brandonbraun653/Ichnaea/hw/ver3/ChargerDesign.md

- Some thoughts on power limitations and low voltage spec.
-
