brandonbraun653/Ichnaea/hw/ver3/InverterDesign.md

- Shall have two power inputs
  - One for a low voltage input (12-100VDC) that goes to an (optional) on-board boost converter.
  - Another for high voltage input (250-480VDC) that can directly feed the inverter.
- Networked control via RS485
