brandonbraun653/Ichnaea/hw/design/ltc7871_ltc7060_dc2886a_buck.asc

C1: cap; 47p
C2: cap; .1µ
C3: cap; 47p
C4: cap; .1µ
C5: cap; 4.7µ
C6: cap; 100p
C7: cap; 1µ
C8: cap; 4.7µ
C9: cap; 1µ
C10: cap; 1µ
C11: cap; .22µ
C12: cap; .22µ
C13: cap; 6.4µ; Rser=31m
C14: polcap; 1300µ; m=6; Rser=20m
C15: cap; 1.1µ; x2; Rser=6m
C16: polcap; 33µ; m=12; Rser=36m
C17: cap; .1µ
C18: cap; .47µ
C19: cap; 1µ
C20: cap; .22µ
C21: cap; .22µ
C22: cap; 6.4µ; Rser=31m
C23: cap; 1.1µ; x2; Rser=6m
C24: cap; .47µ
C25: cap; .1µ
C26: cap; 1µ
C27: cap; .22µ
C28: cap; .22µ
C29: cap; 6.4µ; Rser=31m
C30: cap; 1.1µ; x2; Rser=6m
C31: cap; .1µ
C32: cap; .47µ
C33: cap; 1µ
C34: cap; .22µ
C35: cap; .22µ
C36: cap; 6.4µ; Rser=31m
C37: cap; 1.1µ; x2; Rser=6m
C38: cap; .47µ
C39: cap; .1µ
C40: cap; 1µ
C41: cap; .22µ
C42: cap; .22µ
C43: cap; 6.4µ; Rser=31m
C44: cap; 1.1µ; x2; Rser=6m
C45: cap; .1µ
C46: cap; .47µ
C47: cap; 1µ
C48: cap; .22µ
C49: cap; .22µ
C50: cap; 6.4µ; Rser=31m
C51: cap; 1.1µ; x2; Rser=6m
C52: cap; .47µ
C53: cap; .1µ
C54: cap; 470p
C55: cap; 47p
D1: schottky; RB168MM100
D2: schottky; RB168MM100
D3: schottky; RB168MM100
D4: schottky; RB168MM100
D5: schottky; RB168MM100
D6: schottky; RB168MM100
D7: schottky; RSX205L-30
L1: ind; 4.7µ; Rser=1.6m
L2: ind; 4.7µ; Rser=1.6m
L3: ind; 4.7µ; Rser=1.6m
L4: ind; 4.7µ; Rser=1.6m
L5: ind; 4.7µ; Rser=1.6m
L6: ind; 4.7µ; Rser=1.6m
M1: NMOS; BSC123N08NS3; m=2
M2: NMOS; BSC047N08NS3; m=2
M3: NMOS; BSC123N08NS3; m=2
M4: NMOS; BSC047N08NS3; m=2
M5: NMOS; BSC123N08NS3; m=2
M6: NMOS; BSC047N08NS3; m=2
M7: NMOS; BSC123N08NS3; m=2
M8: NMOS; BSC047N08NS3; m=2
M9: NMOS; BSC123N08NS3; m=2
M10: NMOS; BSC047N08NS3; m=2
M11: NMOS; BSC123N08NS3; m=2
M12: NMOS; BSC047N08NS3; m=2
R1: res; 107K
R2: res; 10K
R3: res; 1K
R4: res; 3.01K
R5: res; 499K
R6: res; 12.7K
R7: res; 45.3K
R8: res; 3.01Meg
R9: res; 48.7K
R10: res; 210K
R11: res; 10K
R12: res; 130K
R13: res; 10K
R14: res; 10K
R15: res; 51K
R17: res; 2.2
R18: res; 10K
R19: res; 30.1K
R20: res; 37.4K
R21: res; 10
R22: res; 0
R24: res; 6.2k
R25: res; 6.2k
R28: res; 10
R29: res; 0
R31: res; 6.2k
R32: res; 6.2k
R34: res; 10
R35: res; 0
R37: res; 6.2k
R38: res; 6.2k
R40: res; 10
R41: res; 0
R43: res; 6.2k
R44: res; 6.2k
R46: res; 10
R47: res; 0
R49: res; 6.2k
R50: res; 6.2k
R52: res; 10
R53: res; 0
R55: res; 6.2k
R56: res; 6.2k
Rload: res; 100
U1: LTC7871
U2: LTC7060
U3: LTC7060
U4: LTC7060
U5: LTC7060
U6: LTC7060
U7: LTC7060
V1: voltage; 48
Named nets: 0, V5, PWMEN, DRVcc, HIGH, LOW, DRVCC
.tran 1.5m startup
Cnom
10u
Cnom
10u
Cnom
10u
Cnom
10u
Cnom
10u
Cnom
10u
Cnom
2.2u
Cnom
2.2u
Cnom
2.2u
Cnom
2.2u
Cnom
2.2u
Cnom
2.2u
LTC7871 High Power PolyPhase Bi-Directional Supply / Charger
48V-to-14V, 6-Phase, 2.5kW Bidirectional Supply/Charger - Buck Mode
HIGH (Input): 30V - 60V  LOW (Output): 14V @ 180A
Note:
  Functions related to SCLK, SDI, SDO and CSB are not modeled
  If the simulation model is not found please update with the "Sync Release" command from the "Tools" menu.
  It remains the customer's responsibility to verify proper and reliable operation in the actual application.
  Component substitution and printed circuit board layout may significantly affect circuit performance or reliability.
  Contact your local sales representative for assistance. This circuit is distributed to customers only for use with ADI parts.
  Copyright © 2021 Analog Devices Inc. All rights reserved.
