brandonbraun653/Ichnaea/hw/ver3/ChargerV3/ChargerV3.kicad_pcb

## KiCad design hw/ver3/ChargerV3/ChargerV3.kicad_pcb (2025-03-12)

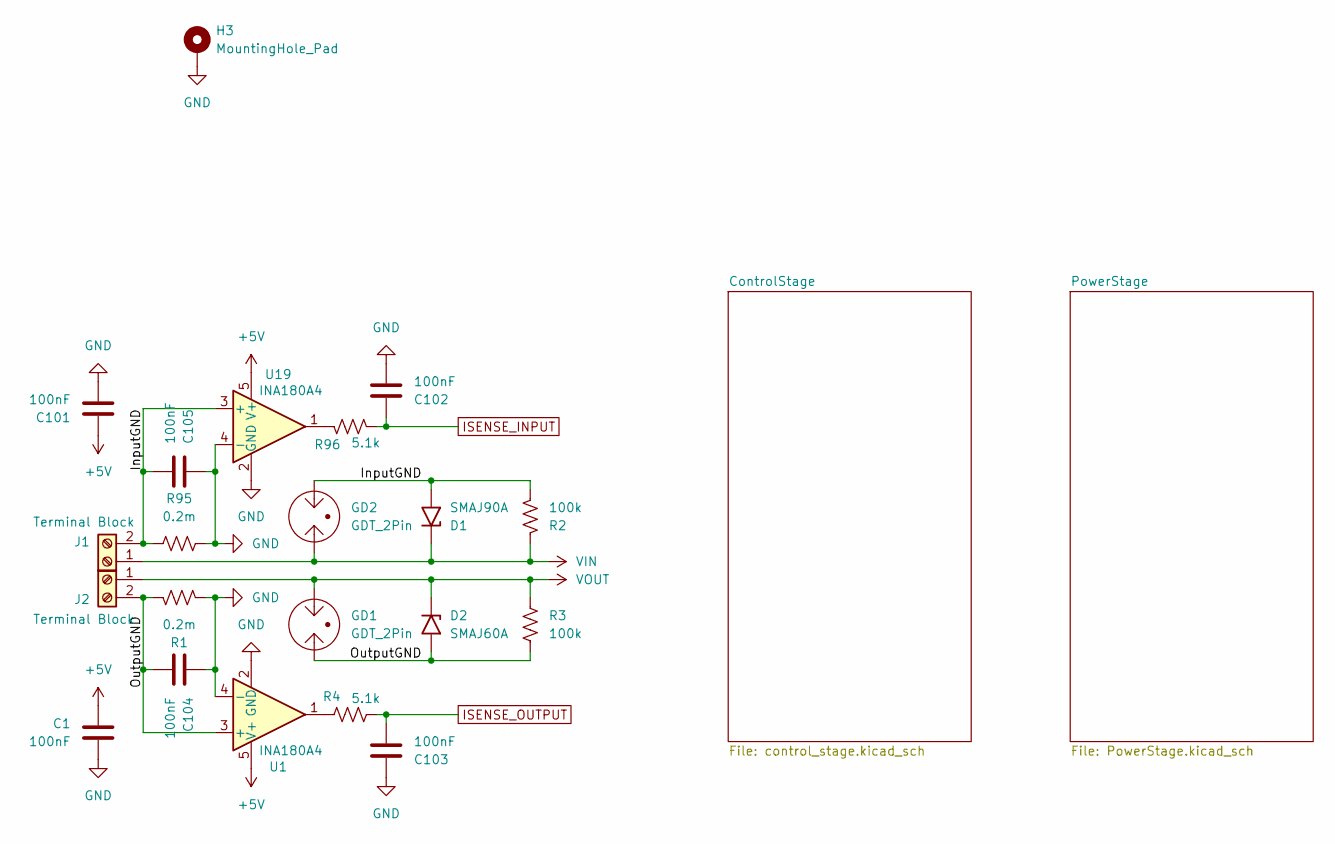
[picture p1: schematic ChargerV3.kicad_sch]

Parts:
C1, C101, C102, C103, C104, C105: 100nF; C_0603_1608Metric; LCSC C14663
D1: SMAJ90A; D_SMA; LCSC C2989723
D2: SMAJ60A; D_SMA; LCSC C707480
GD1, GD2: GDT_2Pin; Fuse_1812_4532Metric_Pad1.30x3.40mm_HandSolder; LCSC C78323
H3: MountingHole_Pad; MountingHole_3.2mm_M3_Pad_Via; Digikey N/A
J1, J2: Terminal Block; KF88SA-16.0-2P; LCSC C707749
R1, R95: 0.2m; Shunt_5930; LCSC C22446543
R2, R3: 100k; R_1206_3216Metric; LCSC C17900
R4, R96: 5.1k; R_0603_1608Metric; LCSC C23186
U1, U19: INA180A4; SOT-23-5; LCSC C188337

Connections:
+5V: C1.1, C101.1, U1.5 (V+), U19.5 (V+); also elsewhere on the board
/InputGND: C105.2, D1.2 (A2), GD2.2, J1.2, R2.2, R95.1, U19.3 (+)
/OutputGND: C104.2, D2.2 (A2), GD1.1, J2.2, R1.1, R3.2, U1.3 (+)
GND: C1.2, C101.2, C102.2, C103.1, C104.1, C105.1, H3.1, R1.2, R95.2, U1.2 (GND), U1.4 (-), U19.2 (GND), U19.4 (-); also elsewhere on the board
ISENSE_INPUT: C102.1, R96.1; also elsewhere on the board
ISENSE_OUTPUT: C103.2, R4.1; also elsewhere on the board
unnamed: R4.2, U1.1
unnamed: R96.2, U19.1
VIN: D1.1 (A1), GD2.1, J1.1, R2.1; also elsewhere on the board
VOUT: D2.1 (A1), GD1.2, J2.1, R3.1; also elsewhere on the board

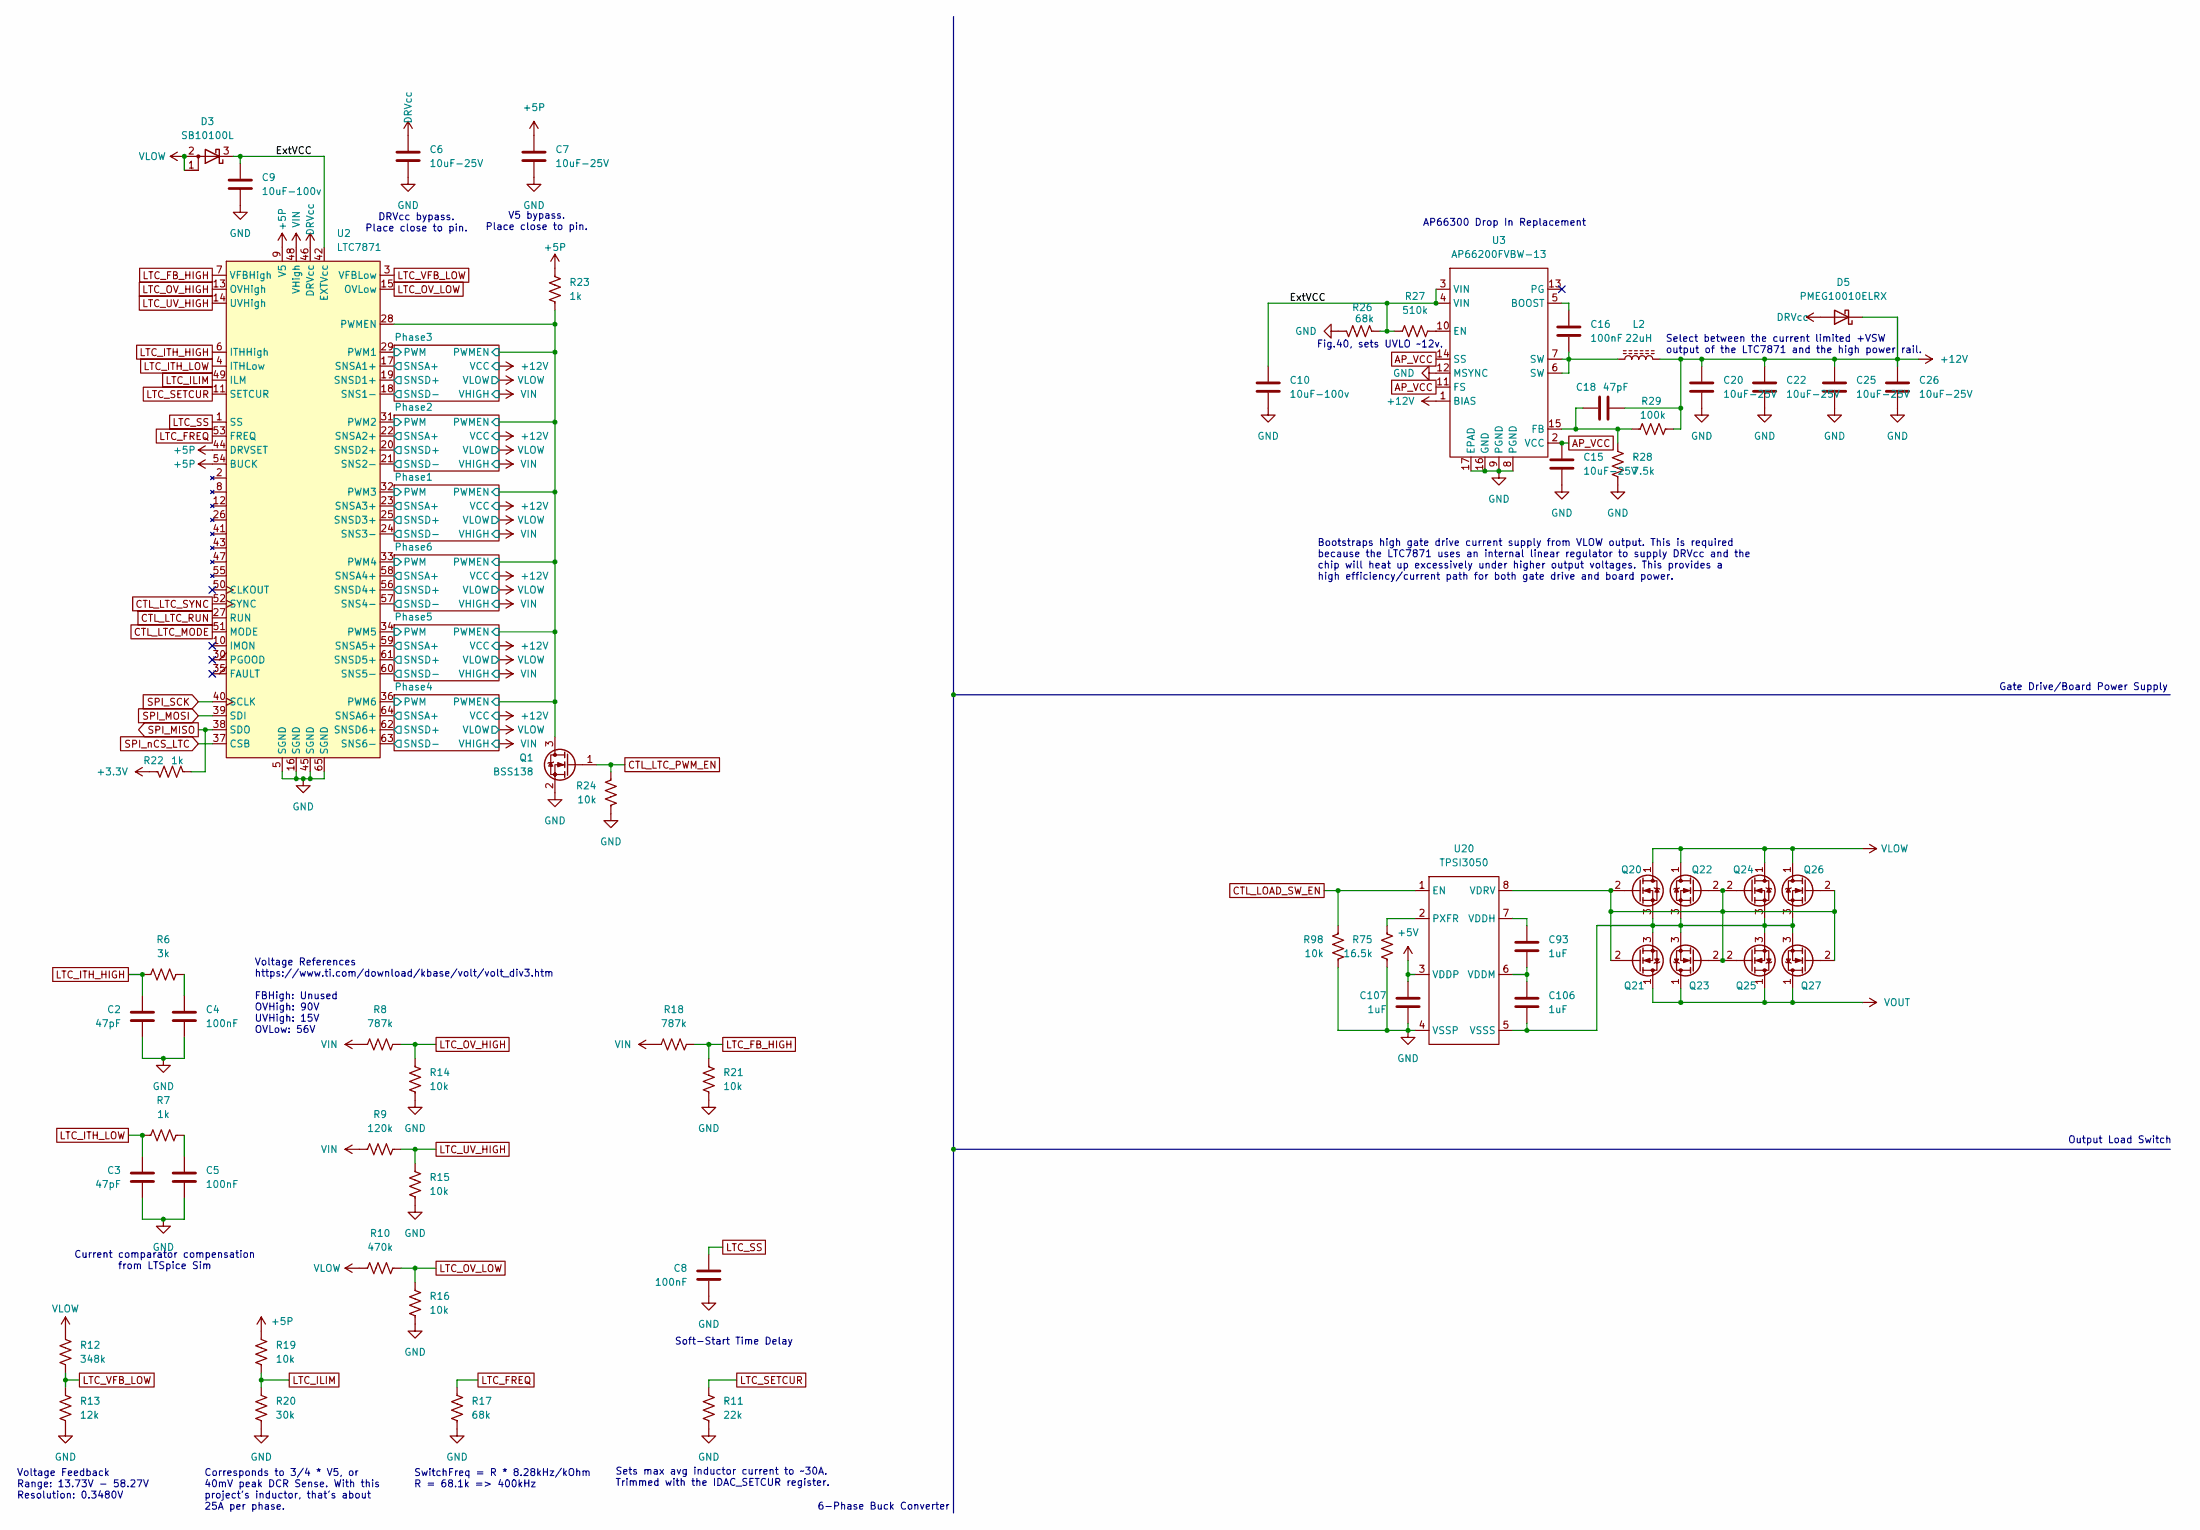
[picture p2: schematic PowerStage.kicad_sch]

Parts:
C2, C3, C18: 47pF; C_0603_1608Metric; LCSC C1671
C4, C5, C8, C16: 100nF; C_0603_1608Metric; LCSC C14663
C6: 10uF-25V; C_0603_1608Metric; Voltage 25; Digikey N/A
C7, C15, C20, C22, C25, C26: 10uF-25V; C_0603_1608Metric; Digikey N/A
C9, C10: 10uF-100v; C_1210_3225Metric_Pad1.33x2.70mm_HandSolder; Digikey 445-CGA6P1X7R1N106M250ACCT-ND
C93, C106, C107: 1uF; C_0603_1608Metric; LCSC C15849
D3: SB10100L; TO-277A; LCSC C113946
D5: PMEG10010ELRX; D_SOD-123; LCSC C179426
L2: 22uH; L_Wuerth_HCI-1040; Digikey N/A
Q1: BSS138; SOT-23; Digikey 5272-BSS138CT-ND
Q20, Q21, Q22, Q23, Q24, Q25, Q26, Q27: HYG053N10NS1C2; TRANS_BSC076N06NS3-G; Digikey N/A
R6: 3k; R_0603_1608Metric; Digikey N/A
R7, R22: 1k; R_0603_1608Metric; Digikey N/A
R8, R18: 787k; R_0805_2012Metric; Digikey P787KHCT-ND
R9: 120k; R_0805_2012Metric; Digikey N/A
R10: 470k; R_0805_2012Metric; LCSC C17709
R11: 22k; R_0603_1608Metric; LCSC C31850
R12: 348k; R_0603_1608Metric; LCSC C23006
R13: 12k; R_0603_1608Metric; LCSC C22790
R14, R15, R16, R19, R21, R24, R98: 10k; R_0603_1608Metric; LCSC C25804
R17: 68k; R_0603_1608Metric; Digikey N/A
R20: 30k; R_0603_1608Metric; Digikey N/A
R23: 1k; R_0603_1608Metric; LCSC C21190
R26: 68k; R_0603_1608Metric; LCSC C23231
R27: 510k; R_0603_1608Metric; LCSC C23192
R28: 7.5k; R_0603_1608Metric; LCSC C23234
R29: 100k; R_0603_1608Metric; LCSC C25803
R75: 16.5k; R_0603_1608Metric; LCSC C2933155
U2: LTC7871; LQFP-64-1EP_10x10mm_P0.5mm_EP6.5x6.5mm; Digikey 505-LTC7871ELWE#PBF-ND
U3: AP66200FVBW-13; QFN-16-1EP_4x4mm_P0.65mm_EP2.5x2.5mm; Digikey 31-AP66200FVBW-13CT-ND
U20: TPSI3050; SOIC-8_7.5x5.85mm_P1.27mm

Connections:
+3.3V: R22.2; also elsewhere on the board
+5P: C7.1, R19.2, R23.2, U2.9 (V5), U2.44 (DRVSET), U2.54 (BUCK)
+5V: C107.1, U20.3 (VDDP); also elsewhere on the board
+12V: C18.2, C20.1, C22.1, C25.1, C26.1, D5.1 (K), L2.2, R29.2, U3.1 (BIAS); also elsewhere on the board
/PowerStage/ExtVCC: C9.1, C10.1, D3.3 (K), R26.1, R27.1, U2.42 (EXTVcc), U3.3 (VIN), U3.4 (VIN)
/PowerStage/Phase1/PWM: U2.32 (PWM3); also elsewhere on the board
/PowerStage/Phase1/PWMEN: Q1.3 (D), R23.1, U2.28 (PWMEN); also elsewhere on the board
/PowerStage/Phase1/SNSA+: U2.23 (SNSA3+); also elsewhere on the board
/PowerStage/Phase1/SNSD+: U2.25 (SNSD3+); also elsewhere on the board
/PowerStage/Phase2/PWM: U2.31 (PWM2); also elsewhere on the board
/PowerStage/Phase2/SNSA+: U2.22 (SNSA2+); also elsewhere on the board
/PowerStage/Phase2/SNSD+: U2.20 (SNSD2+); also elsewhere on the board
/PowerStage/Phase3/PWM: U2.29 (PWM1); also elsewhere on the board
/PowerStage/Phase3/SNSA+: U2.17 (SNSA1+); also elsewhere on the board
/PowerStage/Phase3/SNSD+: U2.19 (SNSD1+); also elsewhere on the board
/PowerStage/Phase4/PWM: U2.36 (PWM6); also elsewhere on the board
/PowerStage/Phase4/SNSA+: U2.64 (SNSA6+); also elsewhere on the board
/PowerStage/Phase4/SNSD+: U2.62 (SNSD6+); also elsewhere on the board
/PowerStage/Phase5/PWM: U2.34 (PWM5); also elsewhere on the board
/PowerStage/Phase5/SNSA+: U2.59 (SNSA5+); also elsewhere on the board
/PowerStage/Phase5/SNSD+: U2.61 (SNSD5+); also elsewhere on the board
/PowerStage/Phase6/PWM: U2.33 (PWM4); also elsewhere on the board
/PowerStage/Phase6/SNSA+: U2.58 (SNSA4+); also elsewhere on the board
/PowerStage/Phase6/SNSD+: U2.56 (SNSD4+); also elsewhere on the board
AP_VCC: C15.1, U3.2 (VCC), U3.11 (FS), U3.14 (SS)
CTL_LOAD_SW_EN: R98.2, U20.1 (EN); also elsewhere on the board
CTL_LTC_MODE: U2.51 (MODE); also elsewhere on the board
CTL_LTC_PWM_EN: Q1.1 (G), R24.2; also elsewhere on the board
CTL_LTC_RUN: U2.27 (RUN); also elsewhere on the board
CTL_LTC_SYNC: U2.52 (SYNC); also elsewhere on the board
DRVcc: C6.1, D5.2 (A), U2.46 (DRVcc)
GND: C2.2, C3.2, C4.2, C5.2, C6.2, C7.2, C8.2, C9.2, C10.2, C15.2, C20.2, C22.2, C25.2, C26.2, C107.2, Q1.2 (S), R11.1, R13.1, R14.1, R15.1, R16.1, R17.1, R20.1, R21.1, R24.1, R26.2, R28.2, R75.2, R98.1, U2.5 (SGND), U2.16 (SGND), U2.45 (SGND), U2.65 (SGND), U3.8 (PGND), U3.9 (PGND), U3.12 (MSYNC), U3.16 (GND), U3.17 (EPAD), U20.4 (VSSP); also elsewhere on the board
LTC_FB_HIGH: R18.2, R21.2, U2.7 (VFBHigh)
LTC_FREQ: R17.2, U2.53 (FREQ)
LTC_ILIM: R19.1, R20.2, U2.49 (ILM)
LTC_ITH_HIGH: C2.1, R6.2, U2.6 (ITHHigh)
LTC_ITH_LOW: C3.1, R7.2, U2.4 (ITHLow)
LTC_OV_HIGH: R8.2, R14.2, U2.13 (OVHigh)
LTC_OV_LOW: R10.2, R16.2, U2.15 (OVLow)
LTC_SETCUR: R11.2, U2.11 (SETCUR)
LTC_SS: C8.1, U2.1 (SS)
LTC_UV_HIGH: R9.2, R15.2, U2.14 (UVHigh)
LTC_VFB_LOW: R12.1, R13.2, U2.3 (VFBLow)
unnamed: C4.1, R6.1
unnamed: C5.1, R7.1
unnamed: C16.2, L2.1, U3.6 (SW), U3.7 (SW)
unnamed: Q20.2 (G), Q21.2 (G), Q22.2 (G), Q23.2 (G), Q24.2 (G), Q25.2 (G), Q26.2 (G), Q27.2 (G), U20.8 (VDRV)
unnamed: C106.2, Q20.3 (S), Q21.3 (S), Q22.3 (S), Q23.3 (S), Q24.3 (S), Q25.3 (S), Q26.3 (S), Q27.3 (S), U20.5 (VSSS)
unnamed: C16.1, U3.5 (BOOST)
unnamed: R27.2, U3.10 (EN)
unnamed: C18.1, R28.1, R29.1, U3.15 (FB)
unnamed: R75.1, U20.2 (PXFR)
unnamed: C93.1, U20.7 (VDDH)
unnamed: C93.2, C106.1, U20.6 (VDDM)
SPI_MISO: R22.1, U2.38 (SDO); also elsewhere on the board
SPI_MOSI: U2.39 (SDI); also elsewhere on the board
SPI_SCK: U2.40 (SCLK); also elsewhere on the board
SPI_nCS_LTC: U2.37 (CSB); also elsewhere on the board
VIN: R8.1, R9.1, R18.1, U2.48 (VHigh); also elsewhere on the board
VLOW: D3.1 (A), D3.2 (A), Q20.1 (D), Q22.1 (D), Q24.1 (D), Q26.1 (D), R10.1, R12.2, U2.18 (SNS1-), U2.21 (SNS2-), U2.24 (SNS3-), U2.57 (SNS4-), U2.60 (SNS5-), U2.63 (SNS6-); also elsewhere on the board
VOUT: Q21.1 (D), Q23.1 (D), Q25.1 (D), Q27.1 (D); also elsewhere on the board

Notes on the sheet:
SwitchFreq = R * 8.28kHz/kOhm R = 68.1k => 400kHz
Output Load Switch
Fig.40, sets UVLO ~12v.
V5 bypass. Place close to pin.
Bootstraps high gate drive current supply from VLOW output. This is required because the LTC7871 uses an internal linear regulator to supply DRVcc and the chip will heat up excessively under higher output voltages. This provides a high efficiency/current path for both gate drive and board power.
Sets max avg inductor current to ~30A. Trimmed with the IDAC_SETCUR register.
Corresponds to 3/4 * V5, or 40mV peak DCR Sense. With this project's inductor, that's about 25A per phase.
6-Phase Buck Converter
Select between the current limited +VSW output of the LTC7871 and the high power rail.
Voltage Feedback Range: 13.73V - 58.27V Resolution: 0.3480V
Current comparator compensation from LTSpice Sim
Soft-Start Time Delay
AP66300 Drop In Replacement
Voltage References https://www.ti.com/download/kbase/volt/volt_div3.htm FBHigh: Unused OVHigh: 90V UVHigh: 15V OVLow: 56V
DRVcc bypass. Place close to pin.
Gate Drive/Board Power Supply

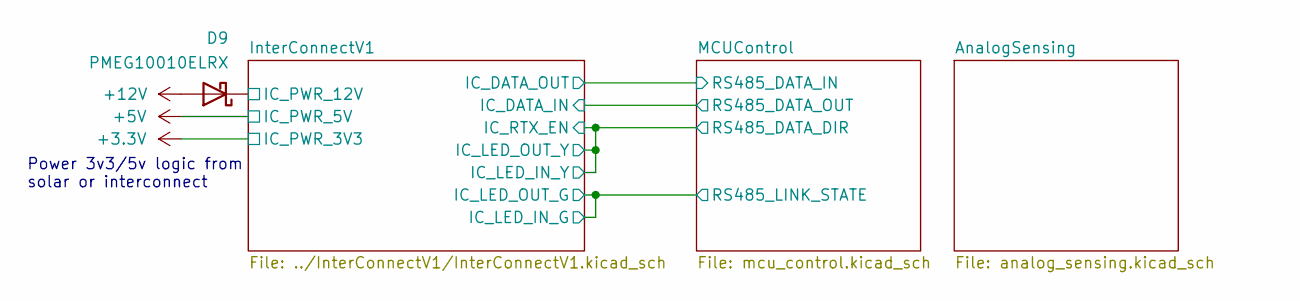
[picture p3: schematic control_stage.kicad_sch]

Parts:
D9: PMEG10010ELRX; D_SOD-123; LCSC C179426

Connections:
+12V: D9.2 (A); also elsewhere on the board
/ControlStage/InterConnectV1/IC_PWR_12V: D9.1 (K); also elsewhere on the board

Notes on the sheet:
Power 3v3/5v logic from solar or interconnect

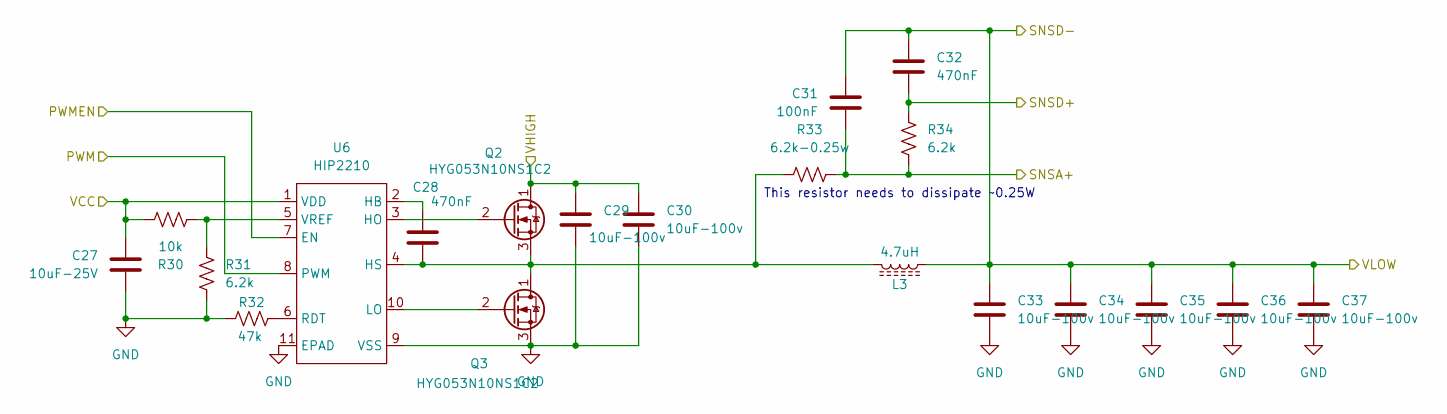
[picture p4: schematic PhaseNDriver.kicad_sch]

Parts:
C27: 10uF-25V; C_0603_1608Metric; Digikey N/A
C28, C32: 470nF; C_0603_1608Metric; Digikey N/A
C29, C30, C33, C34, C35, C36, C37: 10uF-100v; C_1210_3225Metric_Pad1.33x2.70mm_HandSolder; Digikey 445-CGA6P1X7R1N106M250ACCT-ND
C31: 100nF; C_0603_1608Metric; LCSC C14663
L3: 4.7uH; Bournes_L_PQ2614BLA; Digikey PQ2614BLA-3R3K-ND
Q2, Q3: HYG053N10NS1C2; TRANS_BSC076N06NS3-G; Digikey N/A
R30: 10k; R_0603_1608Metric; LCSC C25804
R31, R34: 6.2k; R_0603_1608Metric; Digikey N/A
R32: 47k; R_0603_1608Metric; Digikey N/A
R33: 6.2k-0.25w; R_1206_3216Metric_Pad1.30x1.75mm_HandSolder; Digikey 311-6.20KFRCT-ND
U6: HIP2210; TDFN-10-1EP_4x4mm_P0.8mm_EP2.6x3mm; Digikey 20-HIP2210FRTZ-TCT-ND

Connections:
+12V: C27.1, R30.1, U6.1 (VDD); also elsewhere on the board
/PowerStage/Phase1/PWM: U6.8 (PWM); also elsewhere on the board
/PowerStage/Phase1/PWMEN: U6.7 (EN); also elsewhere on the board
/PowerStage/Phase1/SNSA+: C31.2, R33.2, R34.2; also elsewhere on the board
/PowerStage/Phase1/SNSD+: C32.2, R34.1; also elsewhere on the board
GND: C27.2, C29.2, C30.2, C33.2, C34.2, C35.2, C36.2, C37.2, Q3.3 (S), R31.2, R32.1, U6.9 (VSS), U6.11 (EPAD); also elsewhere on the board
unnamed: Q2.2 (G), U6.3 (HO)
unnamed: C28.2, L3.2, Q2.3 (S), Q3.1 (D), R33.1, U6.4 (HS)
unnamed: Q3.2 (G), U6.10 (LO)
unnamed: C28.1, U6.2 (HB)
unnamed: R32.2, U6.6 (RDT)
unnamed: R30.2, R31.1, U6.5 (VREF)
VIN: C29.1, C30.1, Q2.1 (D); also elsewhere on the board
VLOW: C31.1, C32.1, C33.1, C34.1, C35.1, C36.1, C37.1, L3.1; also elsewhere on the board

Parts of its further copies:
C38, C49, C60, C71, C82: 10uF-25V; C_0603_1608Metric; Digikey N/A
C39, C43, C50, C54, C61, C65, C72, C76, C83, C87: 470nF; C_0603_1608Metric; Digikey N/A
C40, C41, C44, C45, C46, C47, C48, C51, C52, C55, C56, C57, C58, C59, C62, C63, C66, C67, C68, C69, C70, C73, C74, C77, C78, C79, C80, C81, C84, C85, C88, C89, C90, C91, C92: 10uF-100v; C_1210_3225Metric_Pad1.33x2.70mm_HandSolder; Digikey 445-CGA6P1X7R1N106M250ACCT-ND
C42, C53, C64, C75, C86: 100nF; C_0603_1608Metric; LCSC C14663
L4, L5, L6, L7, L8: 4.7uH; Bournes_L_PQ2614BLA; Digikey PQ2614BLA-3R3K-ND
Q4, Q5, Q6, Q7, Q8, Q9, Q10, Q11, Q17, Q18: HYG053N10NS1C2; TRANS_BSC076N06NS3-G; Digikey N/A
R35, R40, R45, R50, R69: 10k; R_0603_1608Metric; LCSC C25804
R36, R39, R41, R44, R46, R49, R51, R54, R70, R73: 6.2k; R_0603_1608Metric; Digikey N/A
R37, R42, R47, R52, R71: 47k; R_0603_1608Metric; Digikey N/A
R38, R43, R48, R53, R72: 6.2k-0.25w; R_1206_3216Metric_Pad1.30x1.75mm_HandSolder; Digikey 311-6.20KFRCT-ND
U7, U8, U9, U10, U11: HIP2210; TDFN-10-1EP_4x4mm_P0.8mm_EP2.6x3mm; Digikey 20-HIP2210FRTZ-TCT-ND

Connections of its further copies:
+12V: C38.1, C49.1, C60.1, C71.1, C82.1, R35.1, R40.1, R45.1, R50.1, R69.1, U7.1 (VDD), U8.1 (VDD), U9.1 (VDD), U10.1 (VDD), U11.1 (VDD); also elsewhere on the board
/PowerStage/Phase1/PWMEN: U7.7 (EN), U8.7 (EN), U9.7 (EN), U10.7 (EN), U11.7 (EN); also elsewhere on the board
/PowerStage/Phase2/PWM: U7.8 (PWM); also elsewhere on the board
/PowerStage/Phase2/SNSA+: C42.2, R38.2, R39.2; also elsewhere on the board
/PowerStage/Phase2/SNSD+: C43.2, R39.1; also elsewhere on the board
/PowerStage/Phase3/PWM: U8.8 (PWM); also elsewhere on the board
/PowerStage/Phase3/SNSA+: C53.2, R43.2, R44.2; also elsewhere on the board
/PowerStage/Phase3/SNSD+: C54.2, R44.1; also elsewhere on the board
/PowerStage/Phase4/PWM: U9.8 (PWM); also elsewhere on the board
/PowerStage/Phase4/SNSA+: C64.2, R48.2, R49.2; also elsewhere on the board
/PowerStage/Phase4/SNSD+: C65.2, R49.1; also elsewhere on the board
/PowerStage/Phase5/PWM: U10.8 (PWM); also elsewhere on the board
/PowerStage/Phase5/SNSA+: C75.2, R53.2, R54.2; also elsewhere on the board
/PowerStage/Phase5/SNSD+: C76.2, R54.1; also elsewhere on the board
/PowerStage/Phase6/PWM: U11.8 (PWM); also elsewhere on the board
/PowerStage/Phase6/SNSA+: C86.2, R72.2, R73.2; also elsewhere on the board
/PowerStage/Phase6/SNSD+: C87.2, R73.1; also elsewhere on the board
GND: C38.2, C40.2, C41.2, C44.2, C45.2, C46.2, C47.2, C48.2, C49.2, C51.2, C52.2, C55.2, C56.2, C57.2, C58.2, C59.2, C60.2, C62.2, C63.2, C66.2, C67.2, C68.2, C69.2, C70.2, C71.2, C73.2, C74.2, C77.2, C78.2, C79.2, C80.2, C81.2, C82.2, C84.2, C85.2, C88.2, C89.2, C90.2, C91.2, C92.2, Q5.3 (S), Q7.3 (S), Q9.3 (S), Q11.3 (S), Q18.3 (S), R36.2, R37.1, R41.2, R42.1, R46.2, R47.1, R51.2, R52.1, R70.2, R71.1, U7.9 (VSS), U7.11 (EPAD), U8.9 (VSS), U8.11 (EPAD), U9.9 (VSS), U9.11 (EPAD), U10.9 (VSS), U10.11 (EPAD), U11.9 (VSS), U11.11 (EPAD); also elsewhere on the board
unnamed: Q4.2 (G), U7.3 (HO)
unnamed: C39.2, L4.2, Q4.3 (S), Q5.1 (D), R38.1, U7.4 (HS)
unnamed: Q5.2 (G), U7.10 (LO)
unnamed: Q6.2 (G), U8.3 (HO)
unnamed: C50.2, L5.2, Q6.3 (S), Q7.1 (D), R43.1, U8.4 (HS)
unnamed: Q7.2 (G), U8.10 (LO)
unnamed: Q8.2 (G), U9.3 (HO)
unnamed: C61.2, L6.2, Q8.3 (S), Q9.1 (D), R48.1, U9.4 (HS)
unnamed: Q9.2 (G), U9.10 (LO)
unnamed: Q10.2 (G), U10.3 (HO)
unnamed: C72.2, L7.2, Q10.3 (S), Q11.1 (D), R53.1, U10.4 (HS)
unnamed: Q11.2 (G), U10.10 (LO)
unnamed: Q17.2 (G), U11.3 (HO)
unnamed: C83.2, L8.2, Q17.3 (S), Q18.1 (D), R72.1, U11.4 (HS)
unnamed: Q18.2 (G), U11.10 (LO)
unnamed: C39.1, U7.2 (HB)
unnamed: R37.2, U7.6 (RDT)
unnamed: R35.2, R36.1, U7.5 (VREF)
unnamed: C50.1, U8.2 (HB)
unnamed: R42.2, U8.6 (RDT)
unnamed: R40.2, R41.1, U8.5 (VREF)
unnamed: C61.1, U9.2 (HB)
unnamed: R47.2, U9.6 (RDT)
unnamed: R45.2, R46.1, U9.5 (VREF)
unnamed: C72.1, U10.2 (HB)
unnamed: R52.2, U10.6 (RDT)
unnamed: R50.2, R51.1, U10.5 (VREF)
unnamed: C83.1, U11.2 (HB)
unnamed: R71.2, U11.6 (RDT)
unnamed: R69.2, R70.1, U11.5 (VREF)
VIN: C40.1, C41.1, C51.1, C52.1, C62.1, C63.1, C73.1, C74.1, C84.1, C85.1, Q4.1 (D), Q6.1 (D), Q8.1 (D), Q10.1 (D), Q17.1 (D); also elsewhere on the board
VLOW: C42.1, C43.1, C44.1, C45.1, C46.1, C47.1, C48.1, C53.1, C54.1, C55.1, C56.1, C57.1, C58.1, C59.1, C64.1, C65.1, C66.1, C67.1, C68.1, C69.1, C70.1, C75.1, C76.1, C77.1, C78.1, C79.1, C80.1, C81.1, C86.1, C87.1, C88.1, C89.1, C90.1, C91.1, C92.1, L4.1, L5.1, L6.1, L7.1, L8.1; also elsewhere on the board

Notes on the sheet:
This resistor needs to dissipate ~0.25W

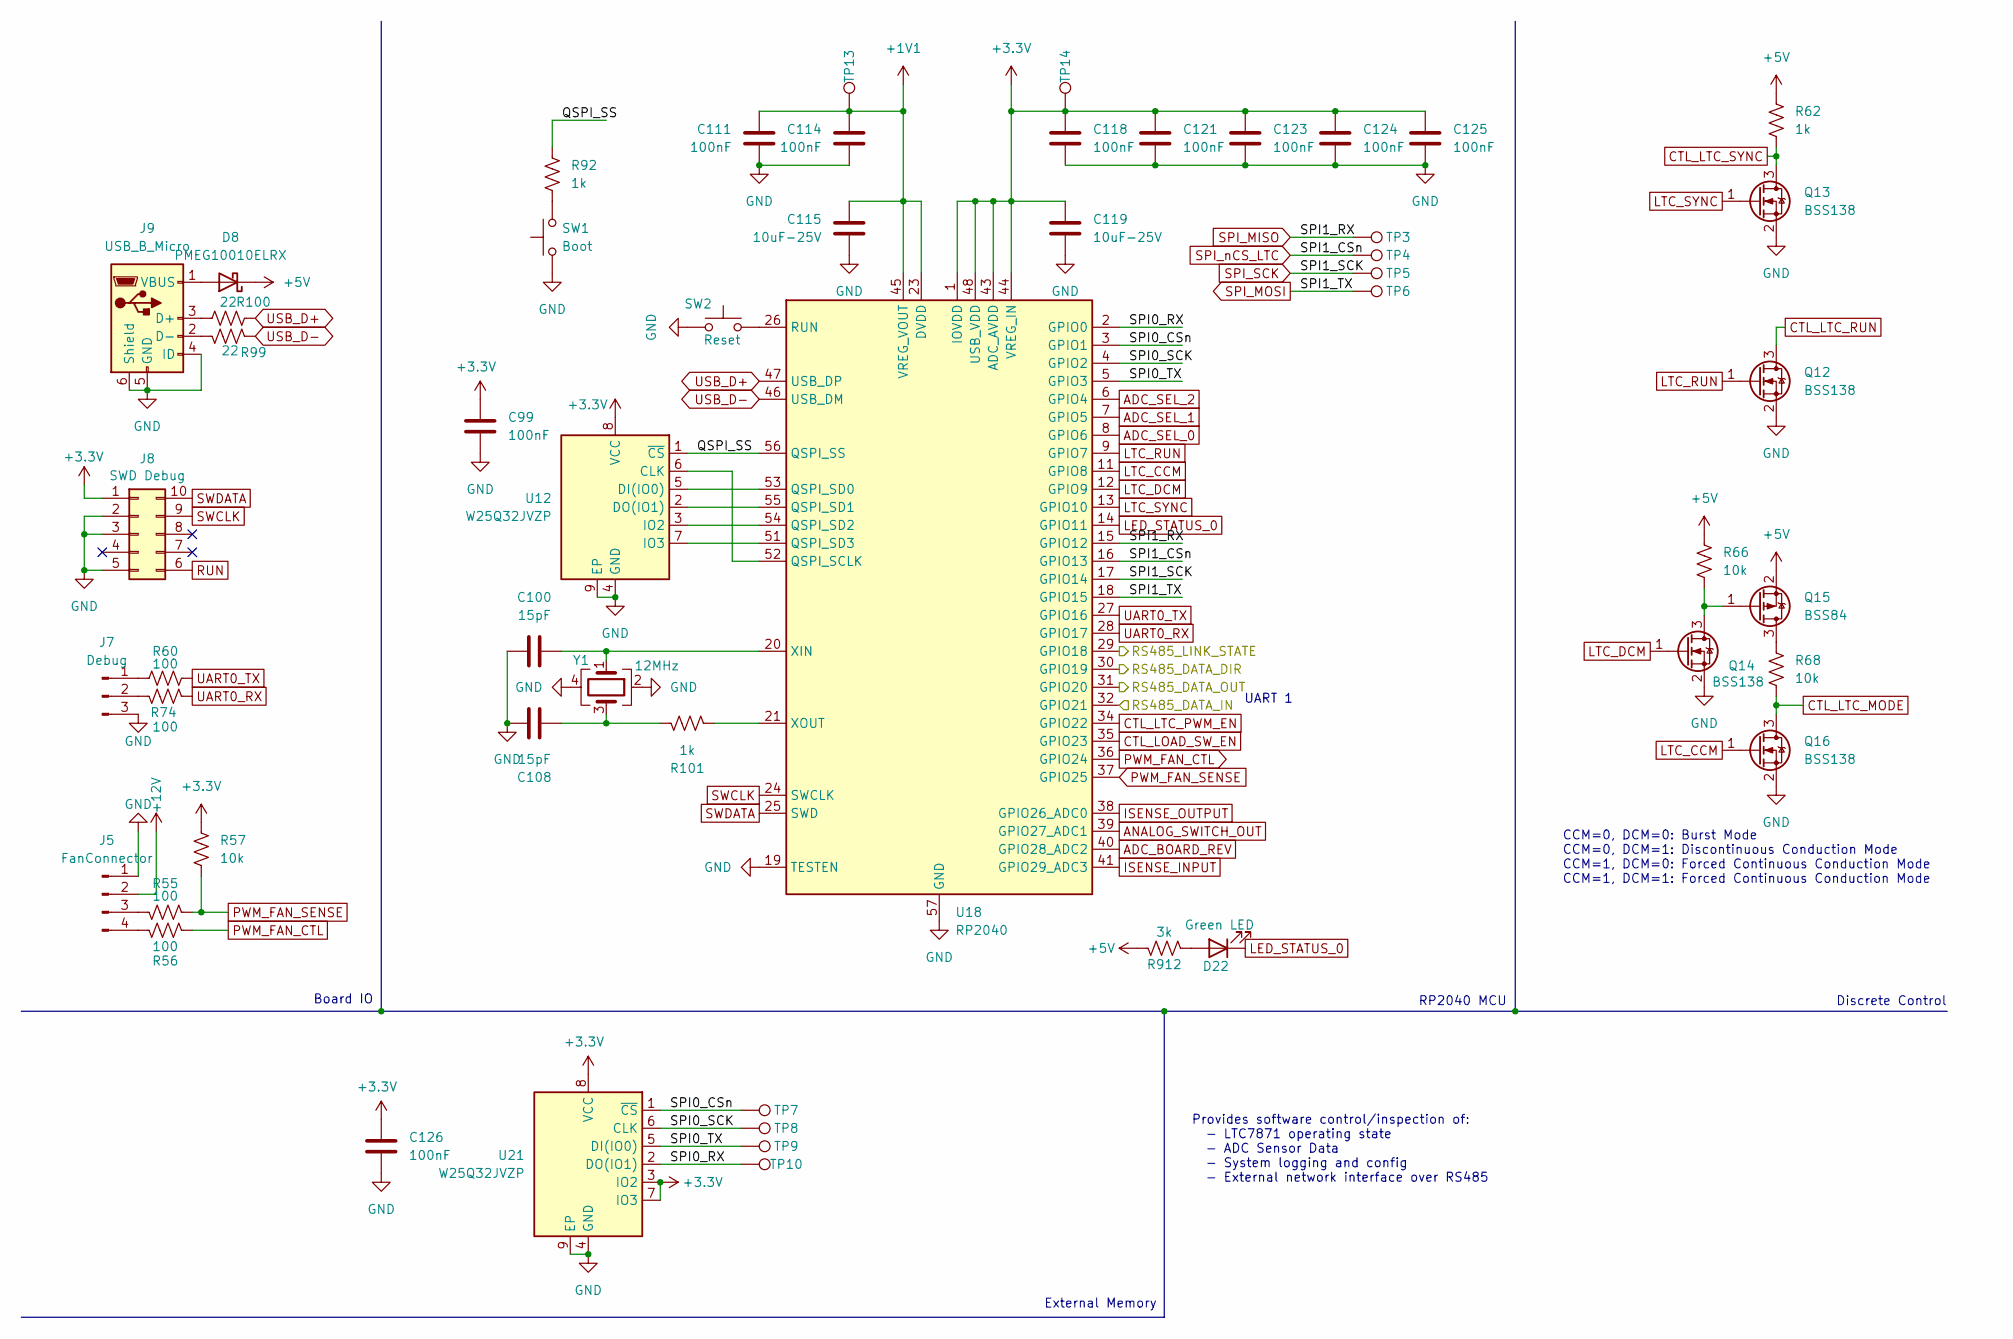
[picture p5: schematic mcu_control.kicad_sch]

Parts:
C99, C111, C114, C118, C121, C123, C124, C125, C126: 100nF; C_0603_1608Metric; LCSC C14663
C100, C108: 15pF; C_0603_1608Metric; Digikey N/A
C115, C119: 10uF-25V; C_0603_1608Metric; Digikey N/A
D8: PMEG10010ELRX; D_SOD-123; LCSC C179426
D22: Green LED; LED_0805_2012Metric; LCSC C2297
J5: FanConnector; Molex_KK-254_AE-6410-04A_1x04_P2.54mm_Vertical; Digikey WM4330-ND
J7: Debug; PinHeader_1x03_P2.54mm_Vertical; Digikey N/A
J8: SWD Debug; JTAG_2x05_P1_27mm_Shrouded_SMD; Digikey 1175-1629-ND
J9: USB_B_Micro; Amphenol-MicroB; LCSC C132350
Q12, Q13, Q14, Q16: BSS138; SOT-23; Digikey 5272-BSS138CT-ND
Q15: BSS84; SOT-23; Digikey 5272-BSS84CT-ND
R55, R56, R60, R74: 100; R_0603_1608Metric; Digikey N/A
R57, R66, R68: 10k; R_0603_1608Metric; LCSC C25804
R62, R92: 1k; R_0603_1608Metric; LCSC C21190
R99, R100: 22; R_0603_1608Metric; LCSC C23345
R101: 1k; R_0603_1608Metric; Digikey N/A
R912: 3k; R_0603_1608Metric; LCSC C126358
SW1: Boot; SW_Tactile_SPST_NO_Straight_CK_PTS636Sx25SMTRLFS; Digikey CKN12321-2-ND
SW2: Reset; SW_Tactile_SPST_NO_Straight_CK_PTS636Sx25SMTRLFS; Digikey CKN12321-2-ND
TP3, TP4, TP5, TP6, TP7, TP8, TP9, TP10, TP13, TP14: TestPoint; TestPoint_Pad_D1.0mm; LCSC N/A
U12, U21: W25Q32JVZP; WSON-8-1EP_6x5mm_P1.27mm_EP3.4x4.3mm; Digikey W25Q32JVZPIQ-ND
U18: RP2040; QFN-56-1EP_7x7mm_P0.4mm_EP3.2x3.2mm; Digikey 2648-SC0914(13)CT-ND
Y1: 12MHz; Crystal_SMD_3225-4Pin_3.2x2.5mm; Digikey XC2613CT-ND

Connections:
+1V1: C111.1, C114.1, C115.1, TP13.1, U18.23 (DVDD), U18.45 (VREG_VOUT), U18.50 (DVDD)
+3.3V: C99.1, C118.1, C119.1, C121.1, C123.1, C124.1, C125.1, C126.1, J8.1, R57.2, TP14.1, U12.8 (VCC), U18.1 (IOVDD), U18.10 (IOVDD), U18.22 (IOVDD), U18.33 (IOVDD), U18.42 (IOVDD), U18.43 (ADC_AVDD), U18.44 (VREG_IN), U18.48 (USB_VDD), U18.49 (IOVDD), U21.3 (IO2), U21.7 (IO3), U21.8 (VCC); also elsewhere on the board
+5V: D8.1 (K), Q15.2 (S), R62.2, R66.2, R912.2; also elsewhere on the board
+12V: J5.2; also elsewhere on the board
/ControlStage/InterConnectV1/IC_DATA_IN: U18.31 (GPIO20); also elsewhere on the board
/ControlStage/InterConnectV1/IC_DATA_OUT: U18.32 (GPIO21); also elsewhere on the board
/ControlStage/InterConnectV1/IC_LED_IN_G: U18.29 (GPIO18); also elsewhere on the board
/ControlStage/InterConnectV1/IC_LED_IN_Y: U18.30 (GPIO19); also elsewhere on the board
/ControlStage/MCUControl/QSPI_SS: R92.2, U12.1 (~CS), U18.56 (QSPI_SS)
/ControlStage/MCUControl/SPI0_CSn: TP7.1, U18.3 (GPIO1), U21.1 (~CS)
/ControlStage/MCUControl/SPI0_RX: TP10.1, U18.2 (GPIO0), U21.2 (DO(IO1))
/ControlStage/MCUControl/SPI0_SCK: TP8.1, U18.4 (GPIO2), U21.6 (CLK)
/ControlStage/MCUControl/SPI0_TX: TP9.1, U18.5 (GPIO3), U21.5 (DI(IO0))
ADC_BOARD_REV: U18.40 (GPIO28_ADC2); also elsewhere on the board
ADC_SEL_0: U18.8 (GPIO6); also elsewhere on the board
ADC_SEL_1: U18.7 (GPIO5); also elsewhere on the board
ADC_SEL_2: U18.6 (GPIO4); also elsewhere on the board
ANALOG_SWITCH_OUT: U18.39 (GPIO27_ADC1); also elsewhere on the board
CTL_LOAD_SW_EN: U18.35 (GPIO23); also elsewhere on the board
CTL_LTC_MODE: Q16.3 (D), R68.2; also elsewhere on the board
CTL_LTC_PWM_EN: U18.34 (GPIO22); also elsewhere on the board
CTL_LTC_RUN: Q12.3 (D); also elsewhere on the board
CTL_LTC_SYNC: Q13.3 (D), R62.1; also elsewhere on the board
GND: C99.2, C100.1, C108.1, C111.2, C114.2, C115.2, C118.2, C119.2, C121.2, C123.2, C124.2, C125.2, C126.2, J5.1, J7.3, J8.2, J8.3, J8.5, J9.4 (ID), J9.5 (GND), J9.6 (Shield), Q12.2 (S), Q13.2 (S), Q14.2 (S), Q16.2 (S), SW1.1, SW2.1, U12.4 (GND), U12.9 (EP), U18.19 (TESTEN), U18.57 (GND), U21.4 (GND), U21.9 (EP), Y1.2, Y1.4; also elsewhere on the board
ISENSE_INPUT: U18.41 (GPIO29_ADC3); also elsewhere on the board
ISENSE_OUTPUT: U18.38 (GPIO26_ADC0); also elsewhere on the board
LED_STATUS_0: D22.1 (K), U18.14 (GPIO11)
LTC_CCM: Q16.1 (G), U18.11 (GPIO8)
LTC_DCM: Q14.1 (G), U18.12 (GPIO9)
LTC_RUN: Q12.1 (G), U18.9 (GPIO7)
LTC_SYNC: Q13.1 (G), U18.13 (GPIO10)
unnamed: C108.2, R101.1, Y1.3
unnamed: D8.2 (A), J9.1 (VBUS)
unnamed: D22.2 (A), R912.1
unnamed: J5.3, R55.2
unnamed: J5.4, R56.1
unnamed: J7.1, R60.1
unnamed: J7.2, R74.1
unnamed: J9.3 (D+), R100.2
unnamed: J9.2 (D-), R99.2
unnamed: Q14.3 (D), Q15.1 (G), R66.1
unnamed: Q15.3 (D), R68.1
unnamed: R92.1, SW1.2
unnamed: U12.6 (CLK), U18.52 (QSPI_SCLK)
unnamed: U12.5 (DI(IO0)), U18.53 (QSPI_SD0)
unnamed: U12.2 (DO(IO1)), U18.55 (QSPI_SD1)
unnamed: U12.3 (IO2), U18.54 (QSPI_SD2)
unnamed: U12.7 (IO3), U18.51 (QSPI_SD3)
unnamed: SW2.2, U18.26 (RUN)
unnamed: C100.2, U18.20 (XIN), Y1.1
unnamed: R101.2, U18.21 (XOUT)
PWM_FAN_CTL: R56.2, U18.36 (GPIO24)
PWM_FAN_SENSE: R55.1, R57.1, U18.37 (GPIO25)
RUN: J8.6
SPI_MISO: TP3.1, U18.15 (GPIO12); also elsewhere on the board
SPI_MOSI: TP6.1, U18.18 (GPIO15); also elsewhere on the board
SPI_SCK: TP5.1, U18.17 (GPIO14); also elsewhere on the board
SPI_nCS_LTC: TP4.1, U18.16 (GPIO13); also elsewhere on the board
SWCLK: J8.9, U18.24 (SWCLK)
SWDATA: J8.10, U18.25 (SWD)
UART0_RX: R74.2, U18.28 (GPIO17)
UART0_TX: R60.2, U18.27 (GPIO16)
USB_D+: R100.1, U18.47 (USB_DP)
USB_D-: R99.1, U18.46 (USB_DM)

Notes on the sheet:
Board IO
UART 1
Provides software control/inspection of: - LTC7871 operating state - ADC Sensor Data - System logging and config - External network interface over RS485
Discrete Control
External Memory
CCM=0, DCM=0: Burst Mode CCM=0, DCM=1: Discontinuous Conduction Mode CCM=1, DCM=0: Forced Continuous Conduction Mode CCM=1, DCM=1: Forced Continuous Conduction Mode
RP2040 MCU

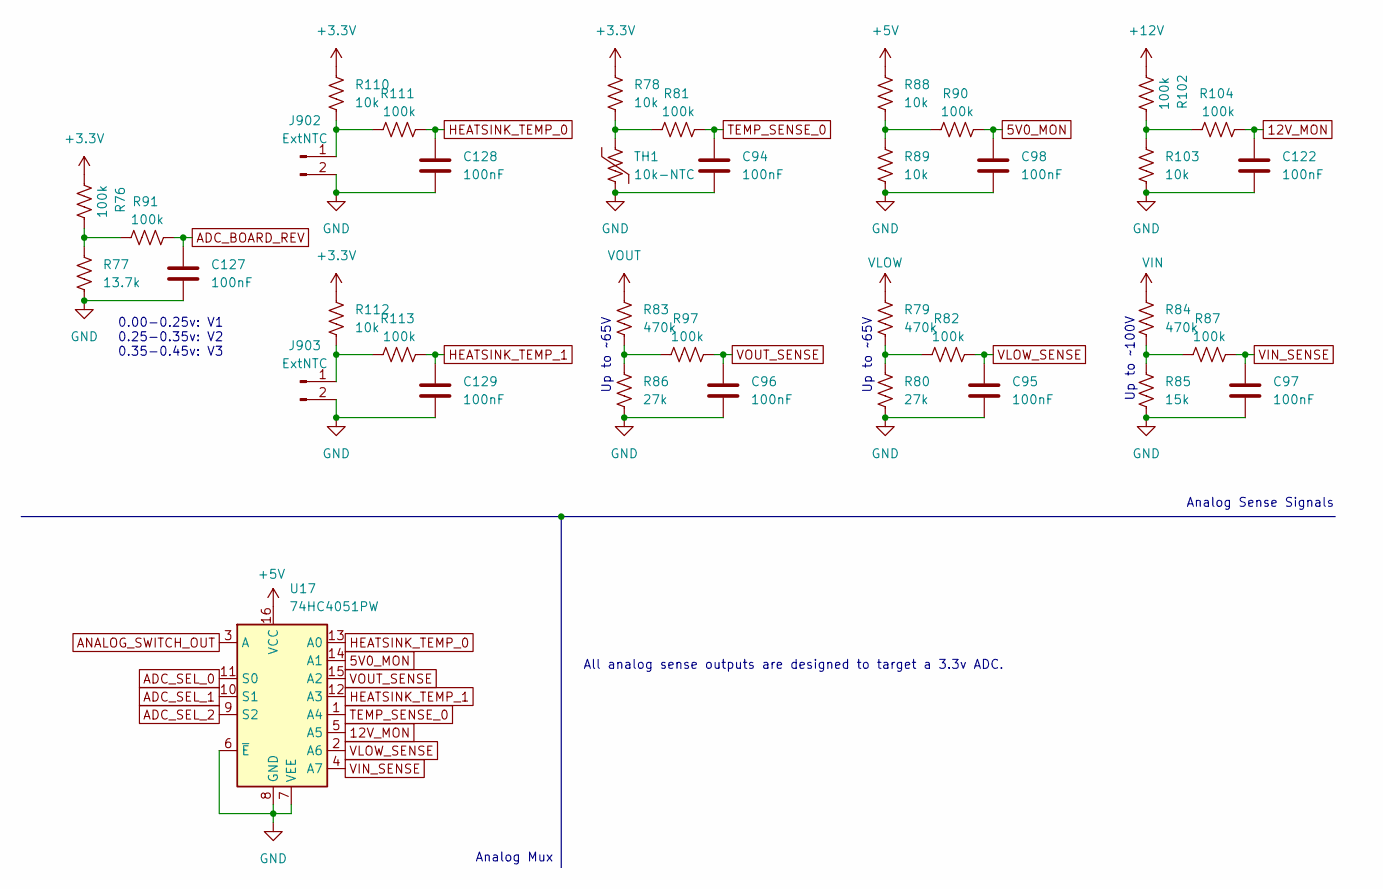
[picture p6: schematic analog_sensing.kicad_sch]

Parts:
C94, C95, C96, C97, C98, C122, C127, C128, C129: 100nF; C_0603_1608Metric; LCSC C14663
J902, J903: ExtNTC; PinHeader_1x02_P2.54mm_Vertical
R76, R81, R82, R87, R90, R91, R97, R102, R104, R111, R113: 100k; R_0603_1608Metric; LCSC C25803
R77: 13.7k; R_0603_1608Metric; LCSC C2930064
R78, R88, R89, R103, R110, R112: 10k; R_0603_1608Metric; LCSC C25804
R79, R83: 470k; R_0805_2012Metric; Digikey N/A
R80, R86: 27k; R_0603_1608Metric; Digikey N/A
R84: 470k; R_0805_2012Metric; LCSC C17709
R85: 15k; R_0603_1608Metric; Digikey N/A
TH1: 10k-NTC; R_0402_1005Metric_Pad0.72x0.64mm_HandSolder; Digikey 445-2550-1-ND
U17: 74HC4051PW; TSSOP-16_4.4x5mm_P0.65mm; Digikey 1727-3064-1-ND

Connections:
5V0_MON: C98.1, R90.2, U17.14 (A1)
12V_MON: C122.1, R104.2, U17.5 (A5)
+3.3V: R76.1, R78.2, R110.2, R112.2; also elsewhere on the board
+5V: R88.2, U17.16 (VCC); also elsewhere on the board
+12V: R102.1; also elsewhere on the board
ADC_BOARD_REV: C127.1, R91.2; also elsewhere on the board
ADC_SEL_0: U17.11 (S0); also elsewhere on the board
ADC_SEL_1: U17.10 (S1); also elsewhere on the board
ADC_SEL_2: U17.9 (S2); also elsewhere on the board
ANALOG_SWITCH_OUT: U17.3 (A); also elsewhere on the board
GND: C94.2, C95.2, C96.2, C97.2, C98.2, C122.2, C127.2, C128.2, C129.2, J902.2, J903.2, R77.1, R80.1, R85.1, R86.1, R89.1, R103.1, TH1.2, U17.6 (~E), U17.7 (VEE), U17.8 (GND); also elsewhere on the board
HEATSINK_TEMP_0: C128.1, R111.2, U17.13 (A0)
HEATSINK_TEMP_1: C129.1, R113.2, U17.12 (A3)
unnamed: J902.1, R110.1, R111.1
unnamed: J903.1, R112.1, R113.1
unnamed: R76.2, R77.2, R91.1
unnamed: R78.1, R81.1, TH1.1
unnamed: R79.1, R80.2, R82.1
unnamed: R83.1, R86.2, R97.1
unnamed: R84.1, R85.2, R87.1
unnamed: R88.1, R89.2, R90.1
unnamed: R102.2, R103.2, R104.1
TEMP_SENSE_0: C94.1, R81.2, U17.1 (A4)
VIN: R84.2; also elsewhere on the board
VIN_SENSE: C97.1, R87.2, U17.4 (A7)
VLOW: R79.2; also elsewhere on the board
VLOW_SENSE: C95.1, R82.2, U17.2 (A6)
VOUT: R83.2; also elsewhere on the board
VOUT_SENSE: C96.1, R97.2, U17.15 (A2)

Notes on the sheet:
Up to ~65V
Analog Sense Signals
0.00-0.25v: V1 0.25-0.35v: V2 0.35-0.45v: V3
Up to ~100V
Analog Mux
All analog sense outputs are designed to target a 3.3v ADC.
