brandonbraun653/Ichnaea/hw/ver3/ChargerV3/ChargerV3.kicad_pcb

## KiCad design hw/ver3/ChargerV3/ChargerV3.kicad_pcb (continued)

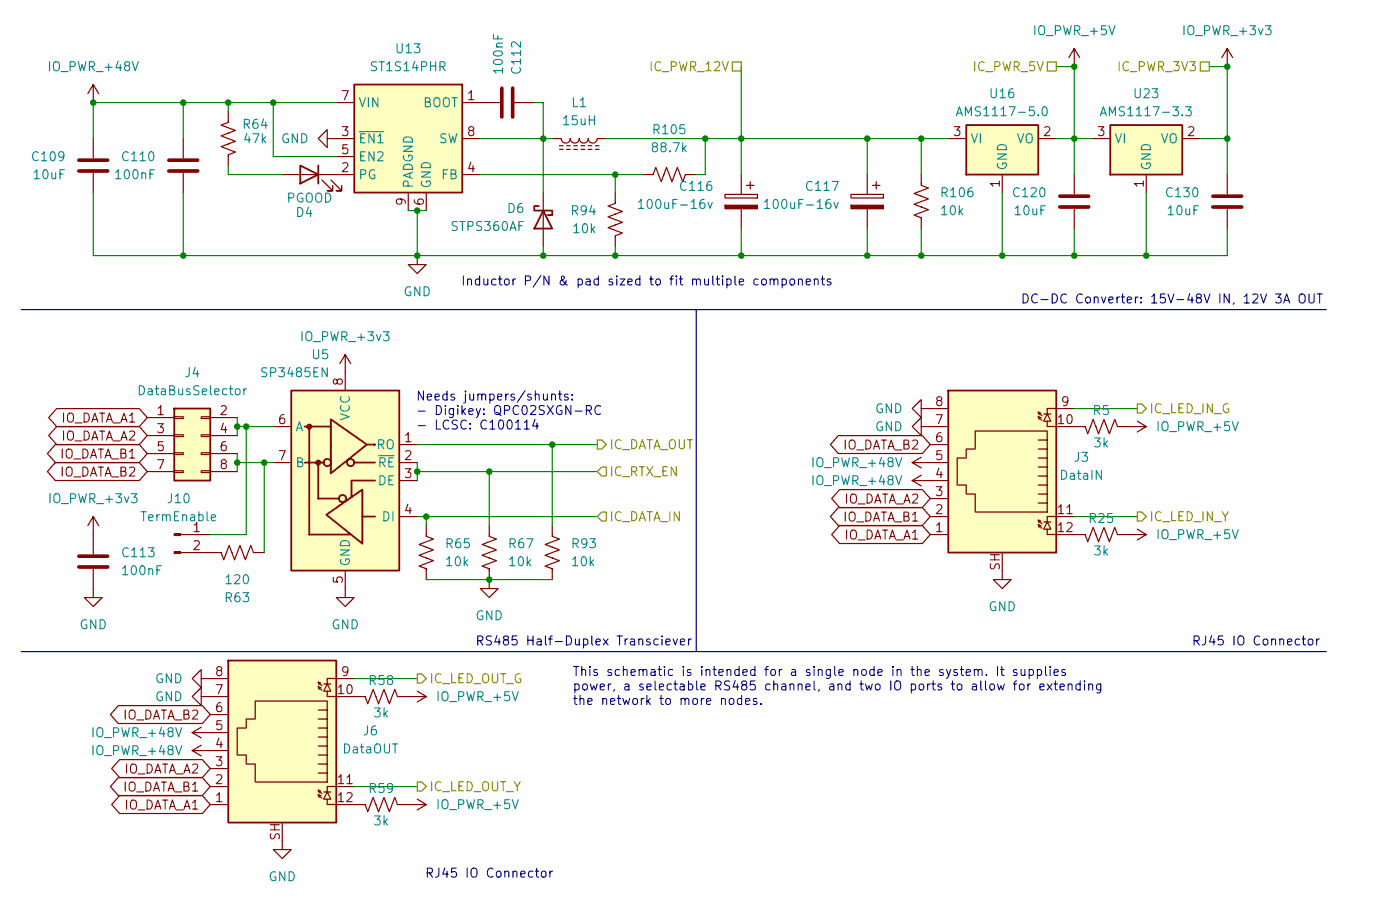
[picture p7: schematic InterConnectV1.kicad_sch]

Parts:
C109, C120, C130: 10uF; C_0603_1608Metric; Digikey N/A
C110, C112, C113: 100nF; C_0603_1608Metric; LCSC C14663
C116, C117: 100uF-16v; CP_Elec_6.3x5.4; LCSC C111600
D4: PGOOD; LED_0805_2012Metric; LCSC C2297
D6: STPS360AF; D_SOD-128; LCSC C5268312
J3: DataIN; RJ45_Amphenol_RJHSE538X; LCSC C386757
J4: DataBusSelector; PinHeader_2x04_P2.54mm_Vertical; LCSC C492421
J6: DataOUT; RJ45_Amphenol_RJHSE538X; LCSC C386757
J10: TermEnable; PinHeader_1x02_P2.54mm_Vertical
L1: 15uH; L_12x12mm_H4.5mm; LCSC C6364678
R5, R25, R58, R59: 3k; R_0603_1608Metric; LCSC C126358
R63: 120; R_0603_1608Metric; LCSC C22787
R64: 47k; R_0603_1608Metric; LCSC C25819
R65, R67, R93, R94, R106: 10k; R_0603_1608Metric; LCSC C25804
R105: 88.7k; R_0603_1608Metric; LCSC C403385
U5: SP3485EN; SOIC-8_3.9x4.9mm_P1.27mm; LCSC C668205
U13: ST1S14PHR; TI_SO-PowerPAD-8; LCSC C84130
U16: AMS1117-5.0; SOT-223-3_TabPin2; LCSC C347223
U23: AMS1117-3.3; SOT-223-3_TabPin2; LCSC C347222

Connections:
+3.3V: C113.1, C130.1, U5.8 (VCC), U23.2 (VO); also elsewhere on the board
+5V: C120.1, R5.2, R25.2, R58.2, R59.2, U16.2 (VO), U23.3 (VI); also elsewhere on the board
/ControlStage/InterConnectV1/IC_DATA_IN: R65.2, U5.4 (DI); also elsewhere on the board
/ControlStage/InterConnectV1/IC_DATA_OUT: R93.2, U5.1 (RO); also elsewhere on the board
/ControlStage/InterConnectV1/IC_LED_IN_G: J3.9, J6.9; also elsewhere on the board
/ControlStage/InterConnectV1/IC_LED_IN_Y: J3.11, J6.11, R67.2, U5.2 (~RE), U5.3 (DE); also elsewhere on the board
/ControlStage/InterConnectV1/IC_PWR_12V: C116.1, C117.1, L1.1, R105.1, R106.2, U16.3 (VI); also elsewhere on the board
GND: C109.2, C110.2, C113.2, C116.2, C117.2, C120.2, C130.2, D6.2 (A), J3.7, J3.8, J3.SH, J6.7, J6.8, J6.SH, R65.1, R67.1, R93.1, R94.1, R106.1, U5.5 (GND), U13.3 (~EN1), U13.6 (GND), U13.9 (PADGND), U16.1 (GND), U23.1 (GND); also elsewhere on the board
IO_DATA_A1: J3.1, J4.1, J6.1
IO_DATA_A2: J3.3, J4.3, J6.3
IO_DATA_B1: J3.2, J4.5, J6.2
IO_DATA_B2: J3.6, J4.7, J6.6
IO_PWR_+48V: C109.1, C110.1, J3.4, J3.5, J6.4, J6.5, R64.1, U13.5 (EN2), U13.7 (VIN)
unnamed: D4.2 (A), R64.2
unnamed: D4.1 (K), U13.2 (PG)
unnamed: C112.1, D6.1 (K), L1.2, U13.8 (SW)
unnamed: J3.10, R5.1
unnamed: J3.12, R25.1
unnamed: J4.6, J4.8, R63.1, U5.7 (B)
unnamed: J6.10, R58.1
unnamed: J6.12, R59.1
unnamed: J4.2, J4.4, J10.1, U5.6 (A)
unnamed: J10.2, R63.2
unnamed: C112.2, U13.1 (BOOT)
unnamed: R94.2, R105.2, U13.4 (FB)

Notes on the sheet:
RJ45 IO Connector
Inductor P/N & pad sized to fit multiple components
DC-DC Converter: 15V-48V IN, 12V 3A OUT
This schematic is intended for a single node in the system. It supplies power, a selectable RS485 channel, and two IO ports to allow for extending the network to more nodes.
Needs jumpers/shunts: - Digikey: QPC02SXGN-RC - LCSC: C100114
RS485 Half-Duplex Transciever

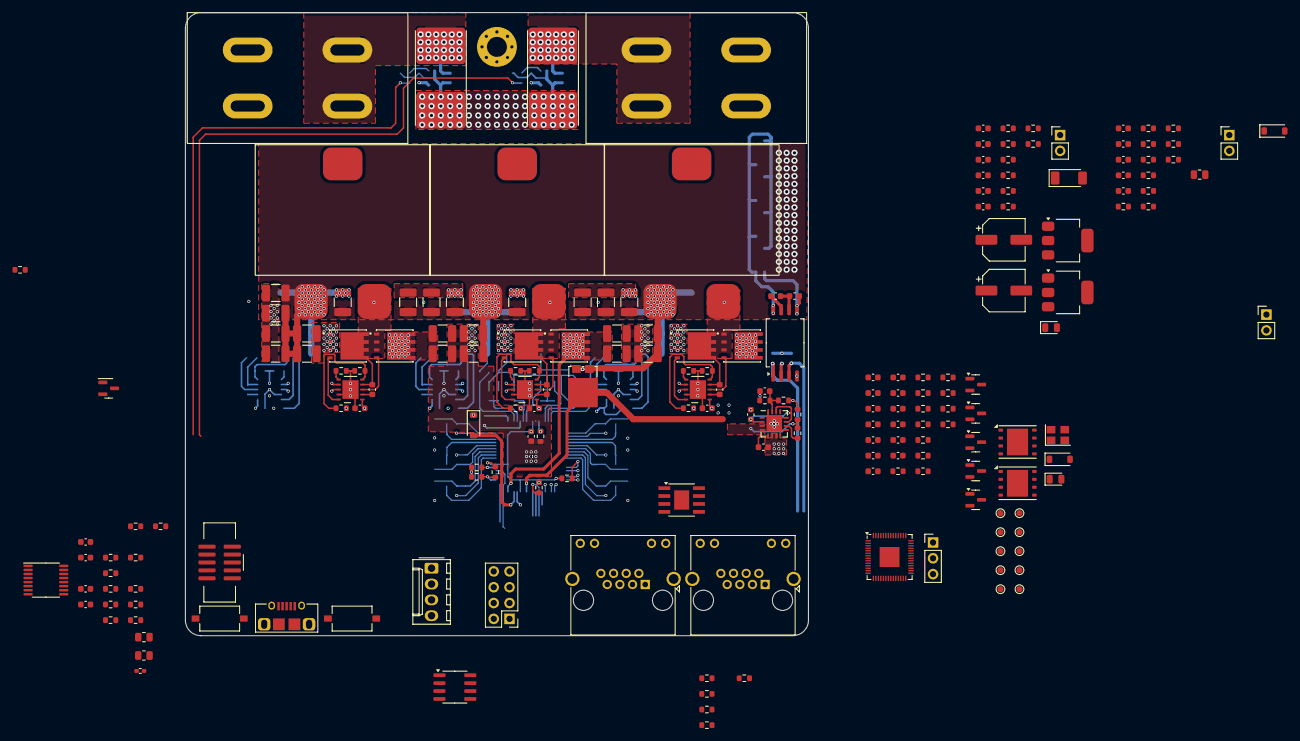
[picture p8: board ChargerV3.kicad_pcb from above]

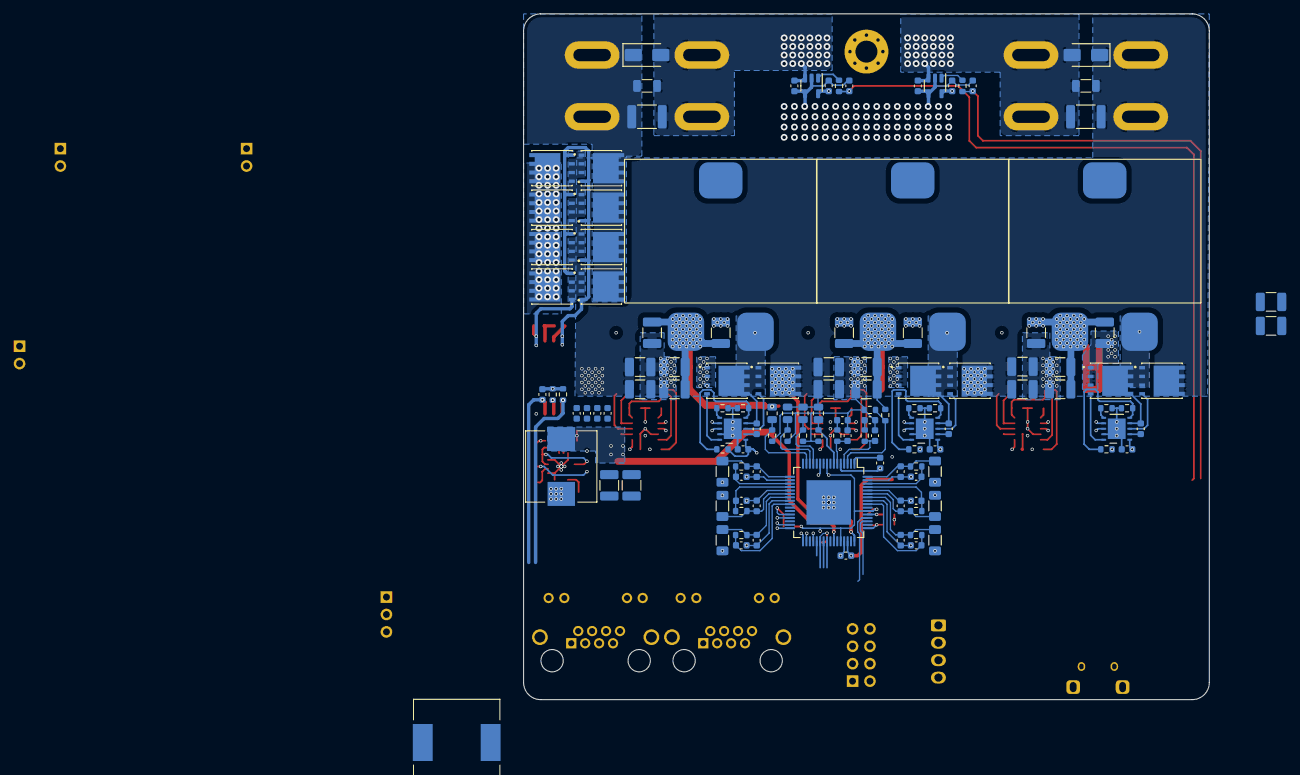
[picture p9: board ChargerV3.kicad_pcb from below]

Board: 4 copper layers, 100.0 x 100.0 mm, 322 parts (125 on the bottom side), 186 nets.
