brandonbraun653/Ichnaea/hw/ver1/PowerStage/IchnaeaV1.kicad_pcb

## KiCad design hw/ver1/PowerStage/IchnaeaV1.kicad_pcb (2024-05-30, an earlier design)

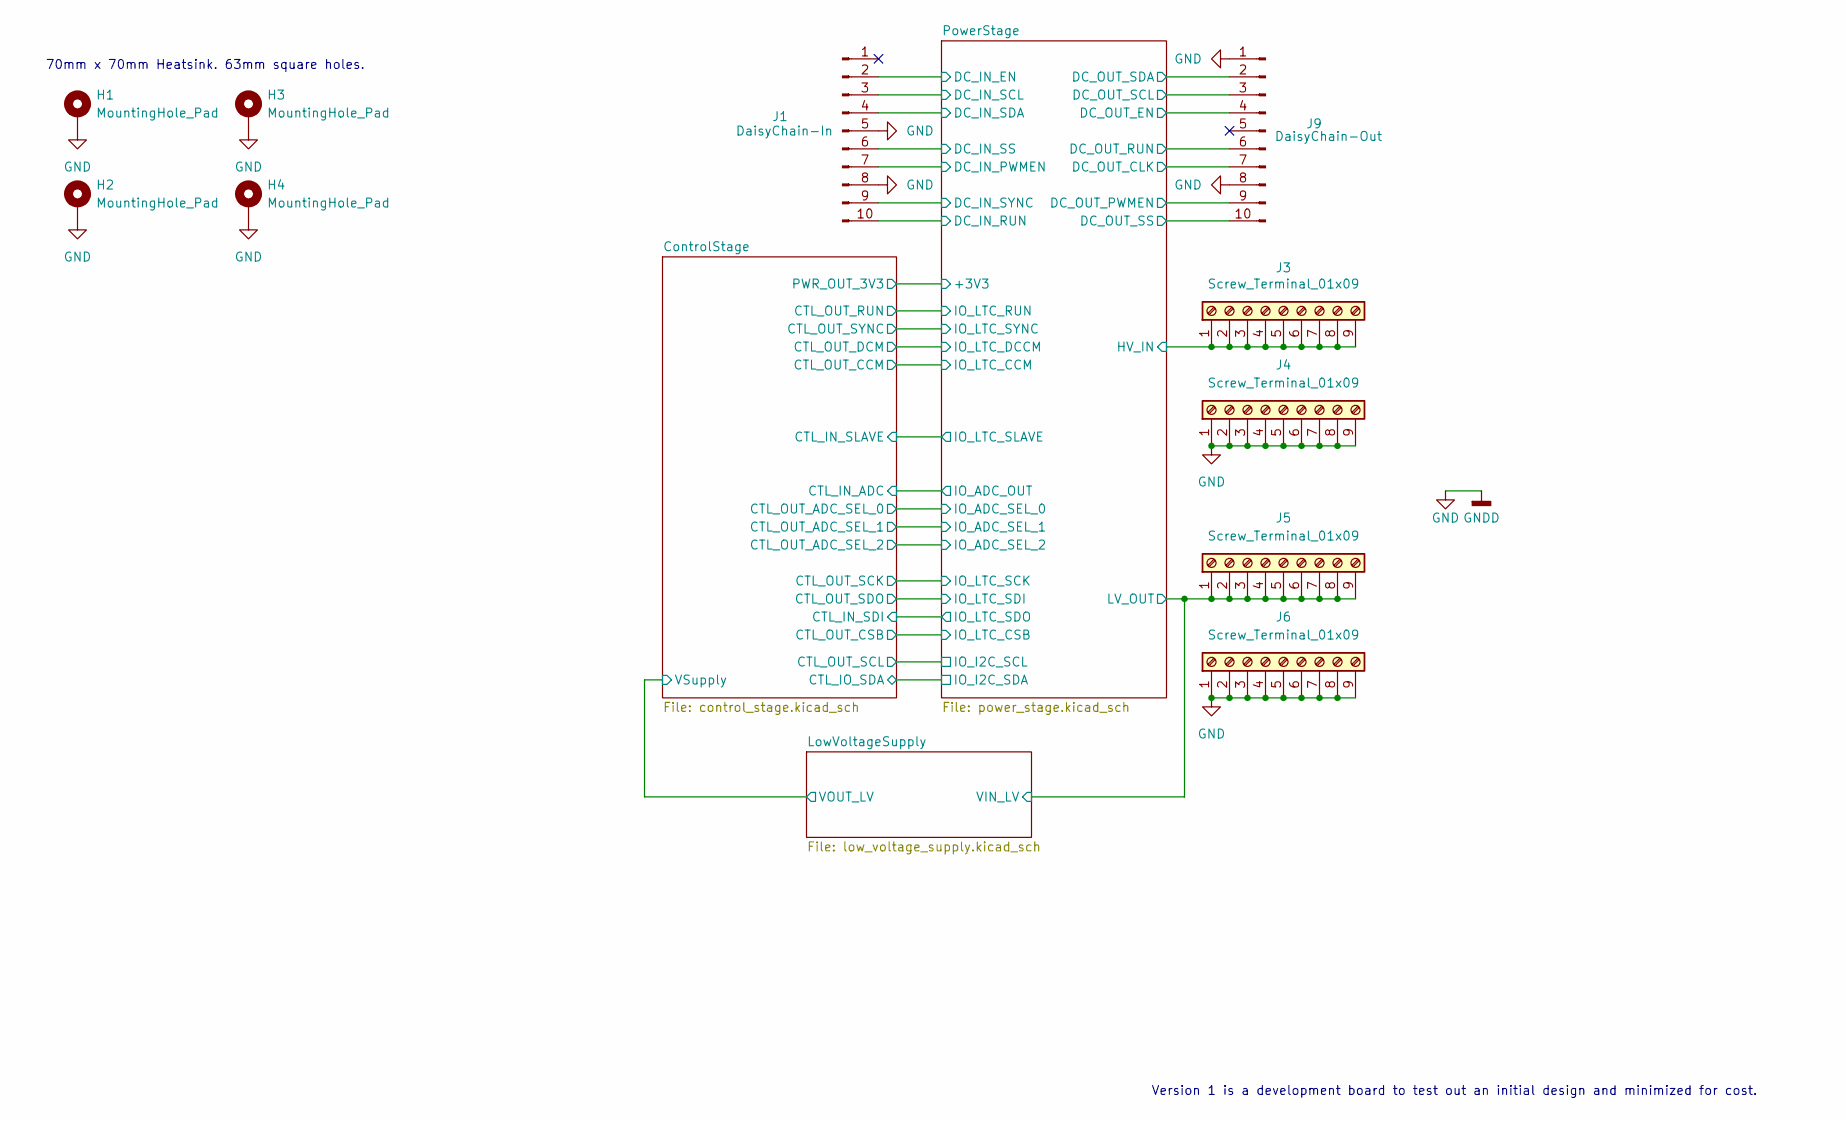
[picture p10: schematic IchnaeaV1.kicad_sch]

Parts:
H1, H2, H3, H4: MountingHole_Pad; MountingHole_3.2mm_M3_Pad_Via; Digikey N/A
J1: DaisyChain-In; JTAG_2x05_P1_27mm_Shrouded_SMD; Digikey 1175-1629-ND
J3, J4, J5, J6: Screw_Terminal_01x09; CONN_74651195R_WRE; Digikey 732-74651195RCT-ND
J9: DaisyChain-Out; JTAG_2x05_P1_27mm_Shrouded_SMD; Digikey 1175-1629-ND

Connections:
/ControlStage/CTL_IO_SDA: J1.4, J9.2; also elsewhere on the board
/ControlStage/CTL_OUT_SCL: J1.3, J9.3; also elsewhere on the board
/PowerStage/DC_IN_EN: J1.2; also elsewhere on the board
/PowerStage/DC_IN_PWMEN: J1.7; also elsewhere on the board
/PowerStage/DC_IN_RUN: J1.10; also elsewhere on the board
/PowerStage/DC_IN_SYNC: J1.9; also elsewhere on the board
/PowerStage/DC_OUT_CLK: J9.7; also elsewhere on the board
/PowerStage/DC_OUT_EN: J9.4; also elsewhere on the board
/PowerStage/DC_OUT_PWMEN: J9.9; also elsewhere on the board
/PowerStage/DC_OUT_RUN: J9.6; also elsewhere on the board
GND: H1.1, H2.1, H3.1, H4.1, J1.5, J1.8, J4.1, J4.2, J4.3, J4.4, J4.5, J4.6, J4.7, J4.8, J4.9, J6.1, J6.2, J6.3, J6.4, J6.5, J6.6, J6.7, J6.8, J6.9, J9.1, J9.8; also elsewhere on the board
HT: J3.1, J3.2, J3.3, J3.4, J3.5, J3.6, J3.7, J3.8, J3.9; also elsewhere on the board
LTC_SS: J1.6, J9.10; also elsewhere on the board
VLOW: J5.1, J5.2, J5.3, J5.4, J5.5, J5.6, J5.7, J5.8, J5.9; also elsewhere on the board

Notes on the sheet:
70mm x 70mm Heatsink. 63mm square holes.
Version 1 is a development board to test out an initial design and minimized for cost.

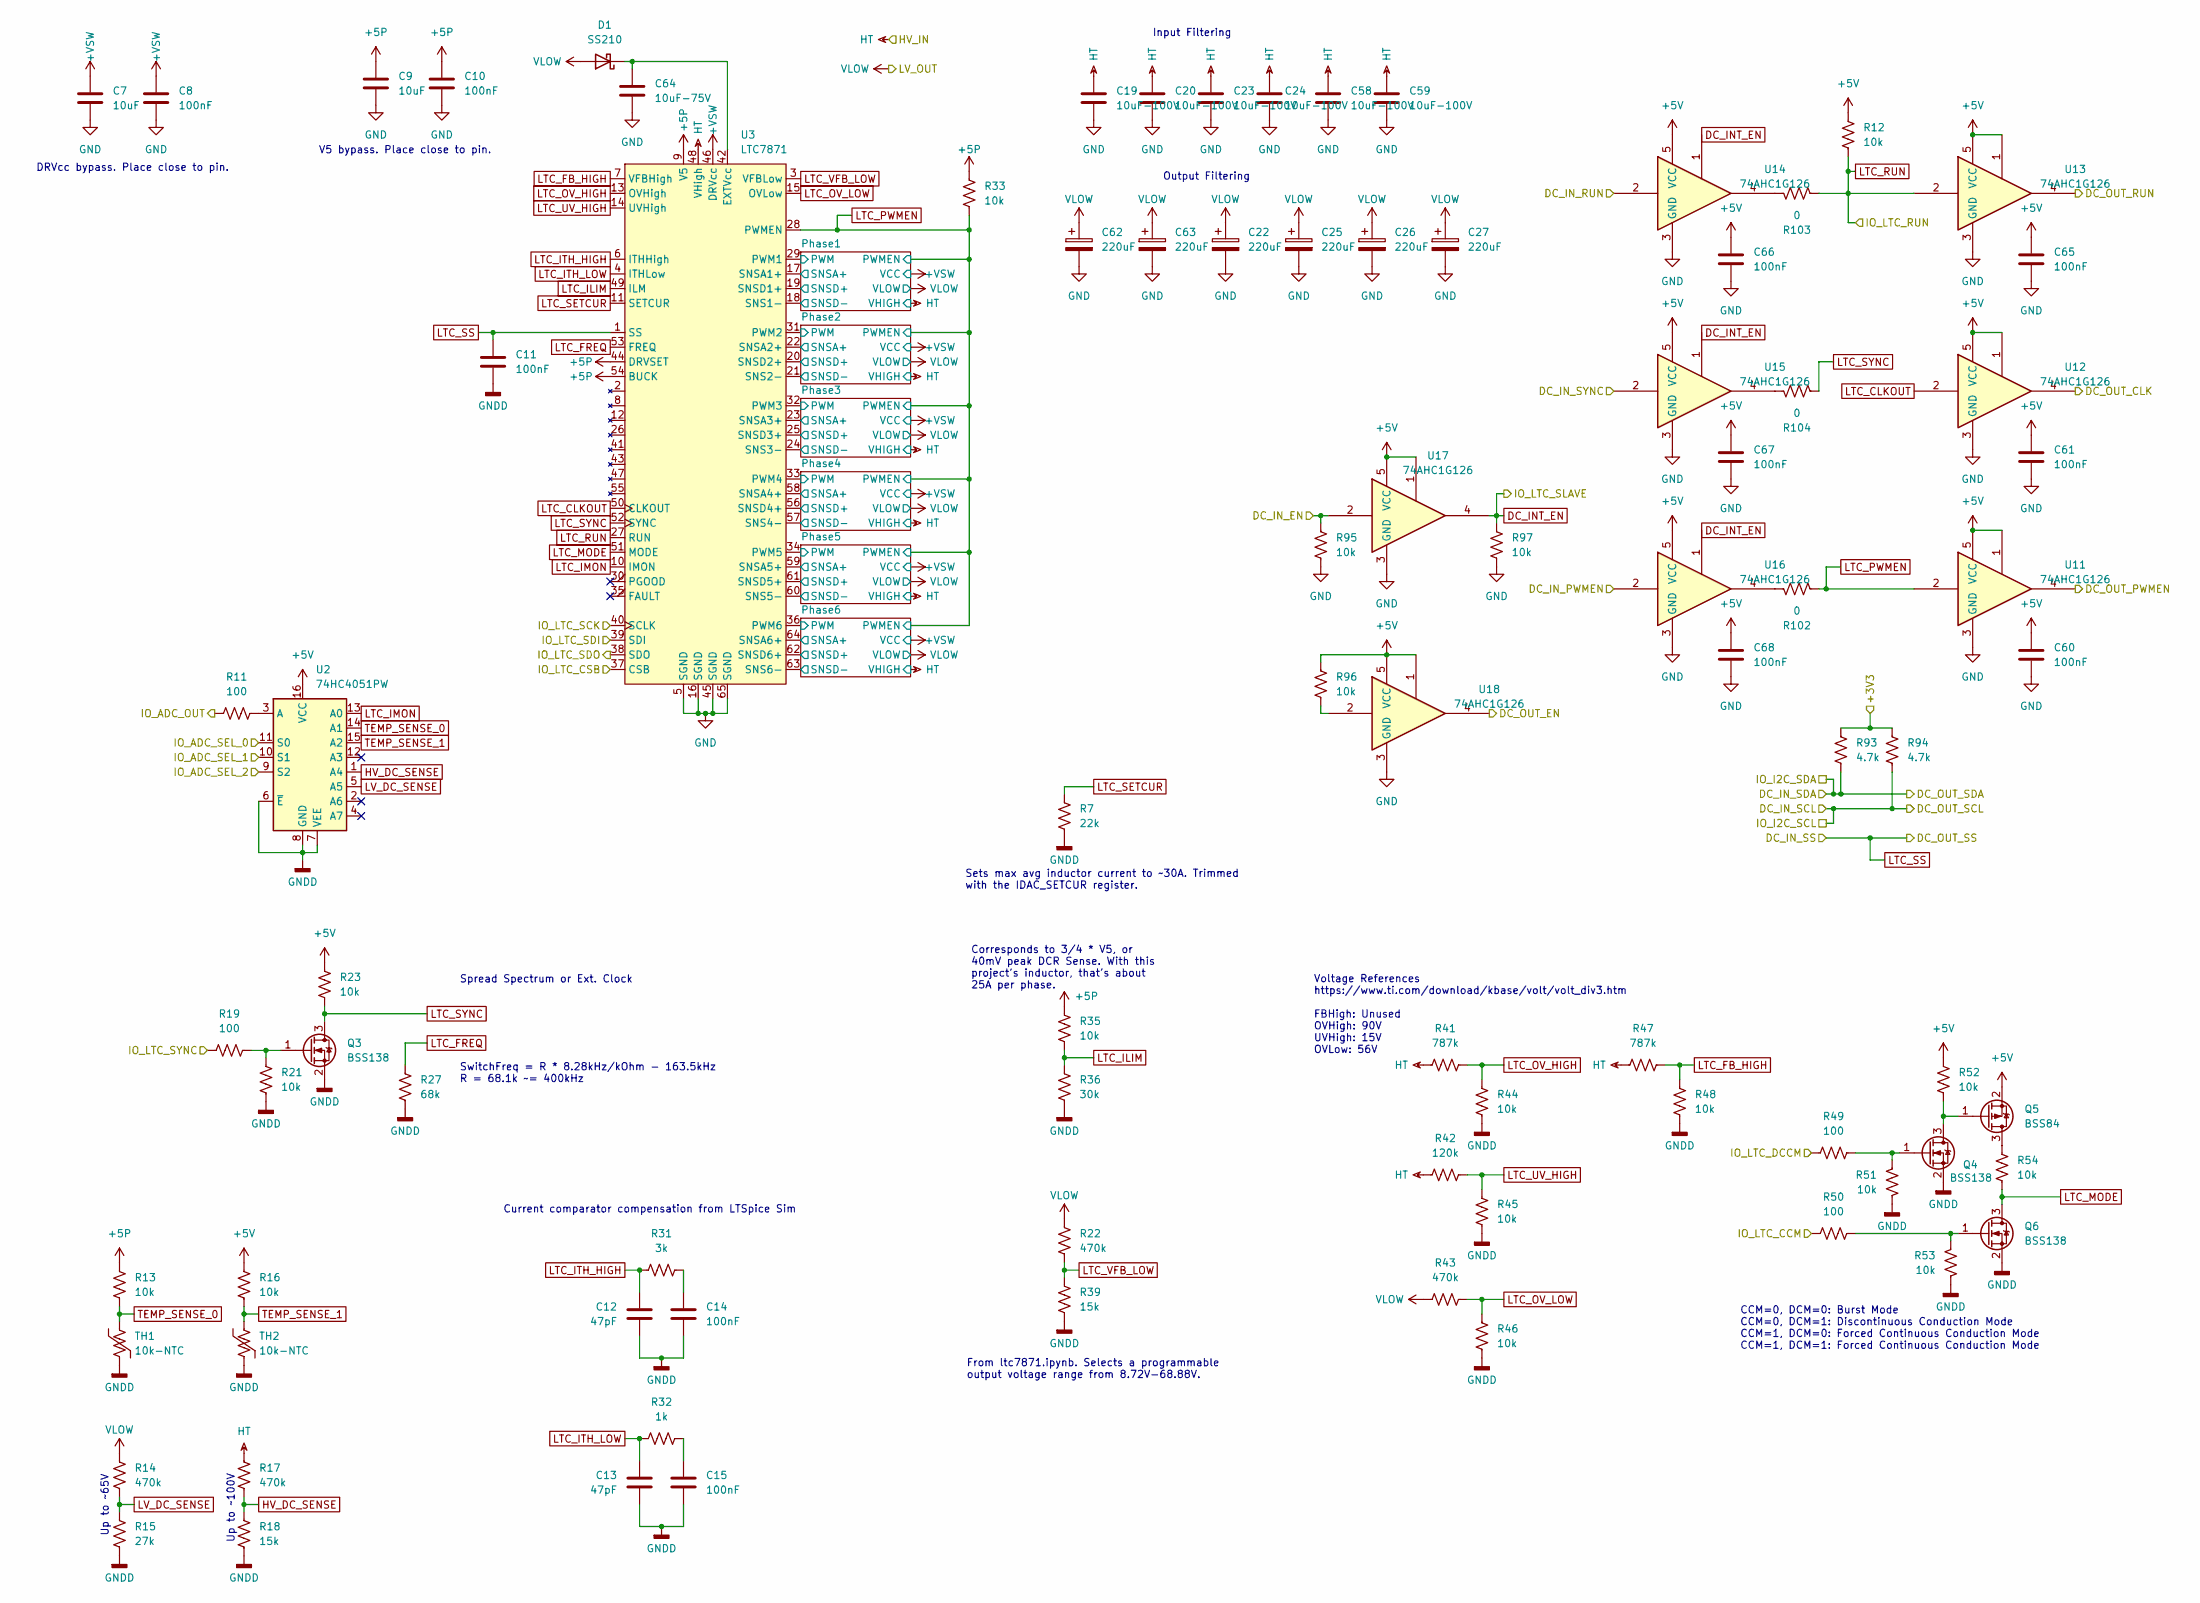
[picture p11: schematic power_stage.kicad_sch]

Parts:
C7, C9: 10uF; C_0603_1608Metric; Digikey N/A
C8, C10, C11, C14, C15, C60, C61, C65, C66, C67, C68: 100nF; C_0603_1608Metric; LCSC C14663
C12, C13: 47pF; C_0603_1608Metric; LCSC C1671
C19, C20, C23, C24, C58, C59: 10uF-100V; C_1210_3225Metric_Pad1.33x2.70mm_HandSolder; Digikey 490-16266-1-ND
C22, C25, C26, C27, C62, C63: 220uF; CP_Radial_D10.0mm_P5.00mm; Digikey 1189-3789-1-ND
C64: 10uF-75V; C_1210_3225Metric_Pad1.33x2.70mm_HandSolder; Digikey 445-CGA6P1X7R1N106M250ACCT-ND
D1: SS210; D_SMA; LCSC C14996
Q3, Q4, Q6: BSS138; SOT-23; Digikey 5272-BSS138CT-ND
Q5: BSS84; SOT-23; Digikey 5272-BSS84CT-ND
R7: 22k; R_0603_1608Metric; LCSC C31850
R11, R19, R49, R50: 100; R_0603_1608Metric; Digikey N/A
R12, R13, R16, R21, R23, R33, R35, R44, R45, R46, R48, R51, R52, R53, R54, R95, R96, R97: 10k; R_0603_1608Metric; LCSC C25804
R14: 470k; R_0603_1608Metric; Digikey N/A
R15: 27k; R_0603_1608Metric; Digikey N/A
R17, R22, R43: 470k; R_0603_1608Metric; LCSC C23178
R18: 15k; R_0603_1608Metric; Digikey N/A
R27: 68k; R_0603_1608Metric; Digikey N/A
R31: 3k; R_0603_1608Metric; Digikey N/A
R32: 1k; R_0603_1608Metric; Digikey N/A
R36: 30k; R_0603_1608Metric; Digikey N/A
R39: 15k; R_0603_1608Metric; LCSC C22809
R41, R47: 787k; R_0603_1608Metric_Pad0.98x0.95mm_HandSolder; Digikey P787KHCT-ND
R42: 120k; R_0603_1608Metric; Digikey N/A
R93, R94: 4.7k; R_0603_1608Metric; LCSC C23162
R102, R103, R104: 0; R_0603_1608Metric; Digikey N/A
TH1, TH2: 10k-NTC; R_0402_1005Metric_Pad0.72x0.64mm_HandSolder; Digikey 445-2550-1-ND
U2: 74HC4051PW; TSSOP-16_4.4x5mm_P0.65mm; Digikey 1727-3064-1-ND
U3: LTC7871; LQFP-64-1EP_10x10mm_P0.5mm_EP6.5x6.5mm; Digikey 505-LTC7871ELWE#PBF-ND
U11, U12, U13, U14, U15, U16, U17, U18: 74AHC1G126; SOT-353_SC-70-5_Handsoldering; Digikey 74AHCT1G126SE-7DICT-ND

Connections:
+3.3V: R93.2, R94.2; also elsewhere on the board
+5P: C9.1, C10.1, R13.2, R33.2, R35.2, U3.9 (V5), U3.44 (DRVSET), U3.54 (BUCK)
+5V: C60.1, C61.1, C65.1, C66.1, C67.1, C68.1, Q5.2 (S), R12.2, R16.2, R23.2, R52.2, R96.2, U2.16 (VCC), U11.1, U11.5 (VCC), U12.1, U12.5 (VCC), U13.1, U13.5 (VCC), U14.5 (VCC), U15.5 (VCC), U16.5 (VCC), U17.1, U17.5 (VCC), U18.1, U18.5 (VCC); also elsewhere on the board
+VSW: C7.1, C8.1, U3.46 (DRVcc); also elsewhere on the board
/ControlStage/CTL_IN_ADC: R11.1; also elsewhere on the board
/ControlStage/CTL_IN_SDI: U3.38 (SDO); also elsewhere on the board
/ControlStage/CTL_IO_SDA: R93.1; also elsewhere on the board
/ControlStage/CTL_OUT_ADC_SEL_0: U2.11 (S0); also elsewhere on the board
/ControlStage/CTL_OUT_ADC_SEL_1: U2.10 (S1); also elsewhere on the board
/ControlStage/CTL_OUT_ADC_SEL_2: U2.9 (S2); also elsewhere on the board
/ControlStage/CTL_OUT_CCM: R50.2; also elsewhere on the board
/ControlStage/CTL_OUT_DCM: R49.2; also elsewhere on the board
/ControlStage/CTL_OUT_SCL: R94.1; also elsewhere on the board
/ControlStage/CTL_OUT_SDO: U3.39 (SDI); also elsewhere on the board
/ControlStage/CTL_OUT_SYNC: R19.2; also elsewhere on the board
/ControlStage/SPI1_CSn: U3.37 (CSB); also elsewhere on the board
/ControlStage/SPI1_SCK: U3.40 (SCLK); also elsewhere on the board
/PowerStage/DC_IN_EN: R95.2, U17.2; also elsewhere on the board
/PowerStage/DC_IN_PWMEN: U16.2; also elsewhere on the board
/PowerStage/DC_IN_RUN: U14.2; also elsewhere on the board
/PowerStage/DC_IN_SYNC: U15.2; also elsewhere on the board
/PowerStage/DC_OUT_CLK: U12.4; also elsewhere on the board
/PowerStage/DC_OUT_EN: U18.4; also elsewhere on the board
/PowerStage/DC_OUT_PWMEN: U11.4; also elsewhere on the board
/PowerStage/DC_OUT_RUN: U13.4; also elsewhere on the board
/PowerStage/Phase1/PWM: U3.29 (PWM1); also elsewhere on the board
/PowerStage/Phase1/SNSA+: U3.17 (SNSA1+); also elsewhere on the board
/PowerStage/Phase1/SNSD+: U3.19 (SNSD1+); also elsewhere on the board
/PowerStage/Phase2/PWM: U3.31 (PWM2); also elsewhere on the board
/PowerStage/Phase2/SNSA+: U3.22 (SNSA2+); also elsewhere on the board
/PowerStage/Phase2/SNSD+: U3.20 (SNSD2+); also elsewhere on the board
/PowerStage/Phase3/PWM: U3.32 (PWM3); also elsewhere on the board
/PowerStage/Phase3/SNSA+: U3.23 (SNSA3+); also elsewhere on the board
/PowerStage/Phase3/SNSD+: U3.25 (SNSD3+); also elsewhere on the board
/PowerStage/Phase4/PWM: U3.33 (PWM4); also elsewhere on the board
/PowerStage/Phase4/SNSA+: U3.58 (SNSA4+); also elsewhere on the board
/PowerStage/Phase4/SNSD+: U3.56 (SNSD4+); also elsewhere on the board
/PowerStage/Phase5/PWM: U3.34 (PWM5); also elsewhere on the board
/PowerStage/Phase5/SNSA+: U3.59 (SNSA5+); also elsewhere on the board
/PowerStage/Phase5/SNSD+: U3.61 (SNSD5+); also elsewhere on the board
/PowerStage/Phase6/PWM: U3.36 (PWM6); also elsewhere on the board
/PowerStage/Phase6/SNSA+: U3.64 (SNSA6+); also elsewhere on the board
/PowerStage/Phase6/SNSD+: U3.62 (SNSD6+); also elsewhere on the board
DC_INT_EN: R97.2, U14.1, U15.1, U16.1, U17.4; also elsewhere on the board
GND: C7.2, C8.2, C9.2, C10.2, C11.2, C12.2, C13.2, C14.2, C15.2, C19.2, C20.2, C22.2, C23.2, C24.2, C25.2, C26.2, C27.2, C58.2, C59.2, C60.2, C61.2, C62.2, C63.2, C64.2, C65.2, C66.2, C67.2, C68.2, Q3.2 (S), Q4.2 (S), Q6.2 (S), R7.1, R15.1, R18.1, R21.1, R27.1, R36.1, R39.1, R44.1, R45.1, R46.1, R48.1, R51.1, R53.1, R95.1, R97.1, TH1.2, TH2.2, U2.6 (~E), U2.7 (VEE), U2.8 (GND), U3.5 (SGND), U3.16 (SGND), U3.45 (SGND), U3.65 (SGND), U11.3 (GND), U12.3 (GND), U13.3 (GND), U14.3 (GND), U15.3 (GND), U16.3 (GND), U17.3 (GND), U18.3 (GND); also elsewhere on the board
HT: C19.1, C20.1, C23.1, C24.1, C58.1, C59.1, R17.2, R41.1, R42.1, R47.1, U3.48 (VHigh); also elsewhere on the board
HV_DC_SENSE: R17.1, R18.2, U2.1 (A4)
LTC_CLKOUT: U3.50 (CLKOUT), U12.2
LTC_FB_HIGH: R47.2, R48.2, U3.7 (VFBHigh)
LTC_FREQ: R27.2, U3.53 (FREQ)
LTC_ILIM: R35.1, R36.2, U3.49 (ILM)
LTC_IMON: U2.13 (A0), U3.10 (IMON)
LTC_ITH_HIGH: C12.1, R31.2, U3.6 (ITHHigh)
LTC_ITH_LOW: C13.1, R32.2, U3.4 (ITHLow)
LTC_MODE: Q6.3 (D), R54.2, U3.51 (MODE)
LTC_OV_HIGH: R41.2, R44.2, U3.13 (OVHigh)
LTC_OV_LOW: R43.2, R46.2, U3.15 (OVLow)
LTC_PWMEN: R33.1, R102.1, U3.28 (PWMEN), U11.2; also elsewhere on the board
LTC_RUN: R12.1, R103.1, U3.27 (RUN), U13.2; also elsewhere on the board
LTC_SETCUR: R7.2, U3.11 (SETCUR)
LTC_SS: C11.1, U3.1 (SS); also elsewhere on the board
LTC_SYNC: Q3.3 (D), R23.1, R104.1, U3.52 (SYNC)
LTC_UV_HIGH: R42.2, R45.2, U3.14 (UVHigh)
LTC_VFB_LOW: R22.1, R39.2, U3.3 (VFBLow)
LV_DC_SENSE: R14.1, R15.2, U2.5 (A5)
unnamed: C14.1, R31.1
unnamed: C15.1, R32.1
unnamed: C64.1, D1.1 (K), U3.42 (EXTVcc)
unnamed: Q3.1 (G), R19.1, R21.2
unnamed: Q4.3 (D), Q5.1 (G), R52.1
unnamed: Q4.1 (G), R49.1, R51.2
unnamed: Q5.3 (D), R54.1
unnamed: Q6.1 (G), R50.1, R53.2
unnamed: R96.1, U18.2
unnamed: R102.2, U16.4
unnamed: R103.2, U14.4
unnamed: R104.2, U15.4
unnamed: R11.2, U2.3 (A)
TEMP_SENSE_0: R13.1, TH1.1, U2.14 (A1)
TEMP_SENSE_1: R16.1, TH2.1, U2.15 (A2)
VLOW: C22.1, C25.1, C26.1, C27.1, C62.1, C63.1, D1.2 (A), R14.2, R22.2, R43.1, U3.18 (SNS1-), U3.21 (SNS2-), U3.24 (SNS3-), U3.57 (SNS4-), U3.60 (SNS5-), U3.63 (SNS6-); also elsewhere on the board

Notes on the sheet:
Sets max avg inductor current to ~30A. Trimmed with the IDAC_SETCUR register.
Output Filtering
Spread Spectrum or Ext. Clock
Voltage References https://www.ti.com/download/kbase/volt/volt_div3.htm FBHigh: Unused OVHigh: 90V UVHigh: 15V OVLow: 56V
Current comparator compensation from LTSpice Sim
SwitchFreq = R * 8.28kHz/kOhm - 163.5kHz R = 68.1k ~= 400kHz
DRVcc bypass. Place close to pin.
V5 bypass. Place close to pin.
From ltc7871.ipynb. Selects a programmable output voltage range from 8.72V-68.88V.
Input Filtering
CCM=0, DCM=0: Burst Mode CCM=0, DCM=1: Discontinuous Conduction Mode CCM=1, DCM=0: Forced Continuous Conduction Mode CCM=1, DCM=1: Forced Continuous Conduction Mode
Up to ~65V
Up to ~100V
Corresponds to 3/4 * V5, or 40mV peak DCR Sense. With this project's inductor, that's about 25A per phase.

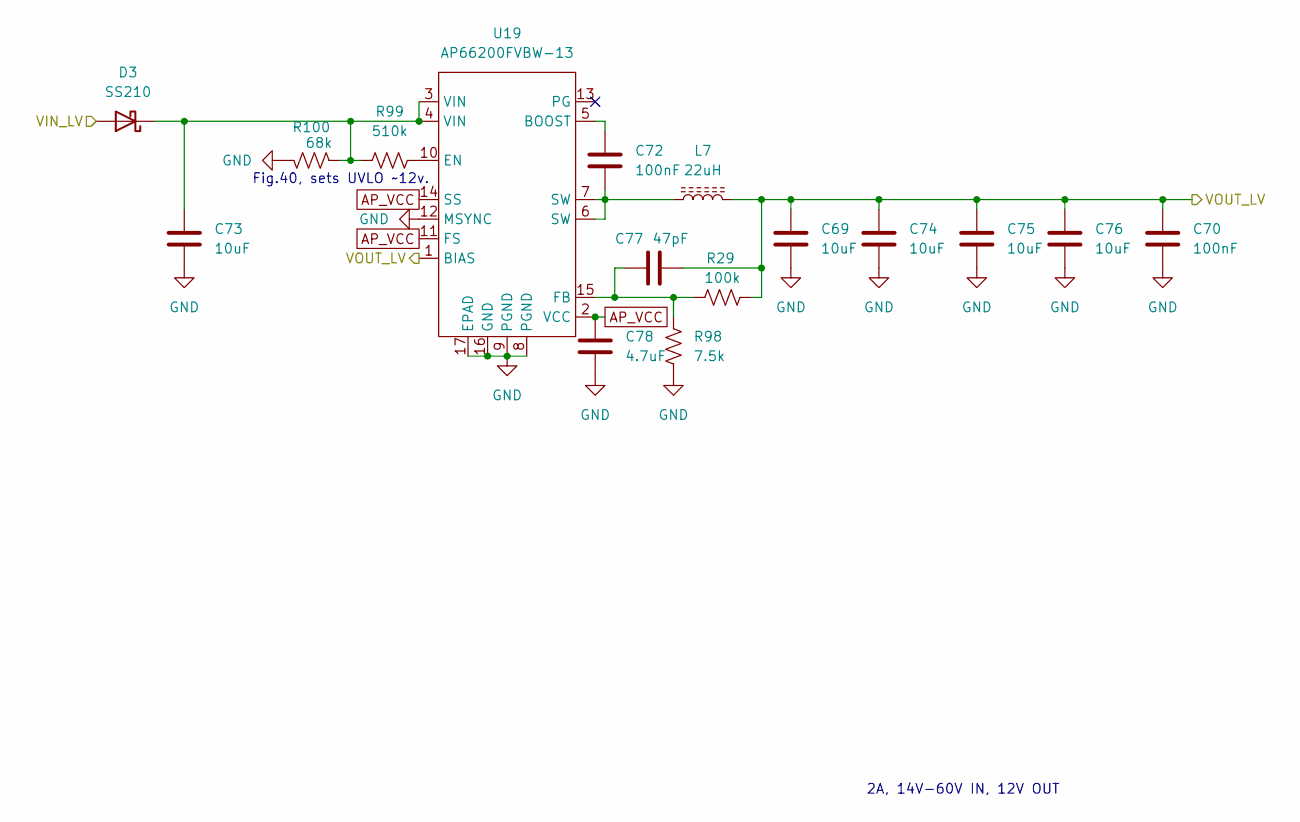
[picture p12: schematic low_voltage_supply.kicad_sch]

Parts:
C69, C73, C74, C75, C76: 10uF; C_0603_1608Metric; Digikey N/A
C70, C72: 100nF; C_0603_1608Metric; LCSC C14663
C77: 47pF; C_0603_1608Metric; LCSC C1671
C78: 4.7uF; C_0603_1608Metric; Digikey N/A
D3: SS210; D_SMA; LCSC C14996
L7: 22uH; TYS5020220M; Digikey 240-2706-1-ND
R29: 100k; R_0603_1608Metric; LCSC C25803
R98: 7.5k; R_0603_1608Metric; LCSC C23234
R99: 510k; R_0603_1608Metric; LCSC C23192
R100: 68k; R_0603_1608Metric; LCSC C23231
U19: AP66200FVBW-13; QFN-16-1EP_4x4mm_P0.65mm_EP2.5x2.5mm; Digikey 31-AP66200FVBW-13CT-ND

Connections:
+12V: C69.1, C70.1, C74.1, C75.1, C76.1, C77.2, L7.2, R29.2, U19.1 (BIAS); also elsewhere on the board
AP_VCC: C78.1, U19.2 (VCC), U19.11 (FS), U19.14 (SS)
GND: C69.2, C70.2, C73.2, C74.2, C75.2, C76.2, C78.2, R98.2, R100.2, U19.8 (PGND), U19.9 (PGND), U19.12 (MSYNC), U19.16 (GND), U19.17 (EPAD); also elsewhere on the board
unnamed: C72.2, L7.1, U19.6 (SW), U19.7 (SW)
unnamed: C73.1, D3.1 (K), R99.1, R100.1, U19.3 (VIN), U19.4 (VIN)
unnamed: C72.1, U19.5 (BOOST)
unnamed: R99.2, U19.10 (EN)
unnamed: C77.1, R29.1, R98.1, U19.15 (FB)
VLOW: D3.2 (A); also elsewhere on the board

Notes on the sheet:
2A, 14V-60V IN, 12V OUT
Fig.40, sets UVLO ~12v.
