brandonbraun653/Ichnaea/hw/ver1/PowerStage/IchnaeaV1.kicad_pcb

## KiCad design hw/ver1/PowerStage/IchnaeaV1.kicad_pcb (continued)

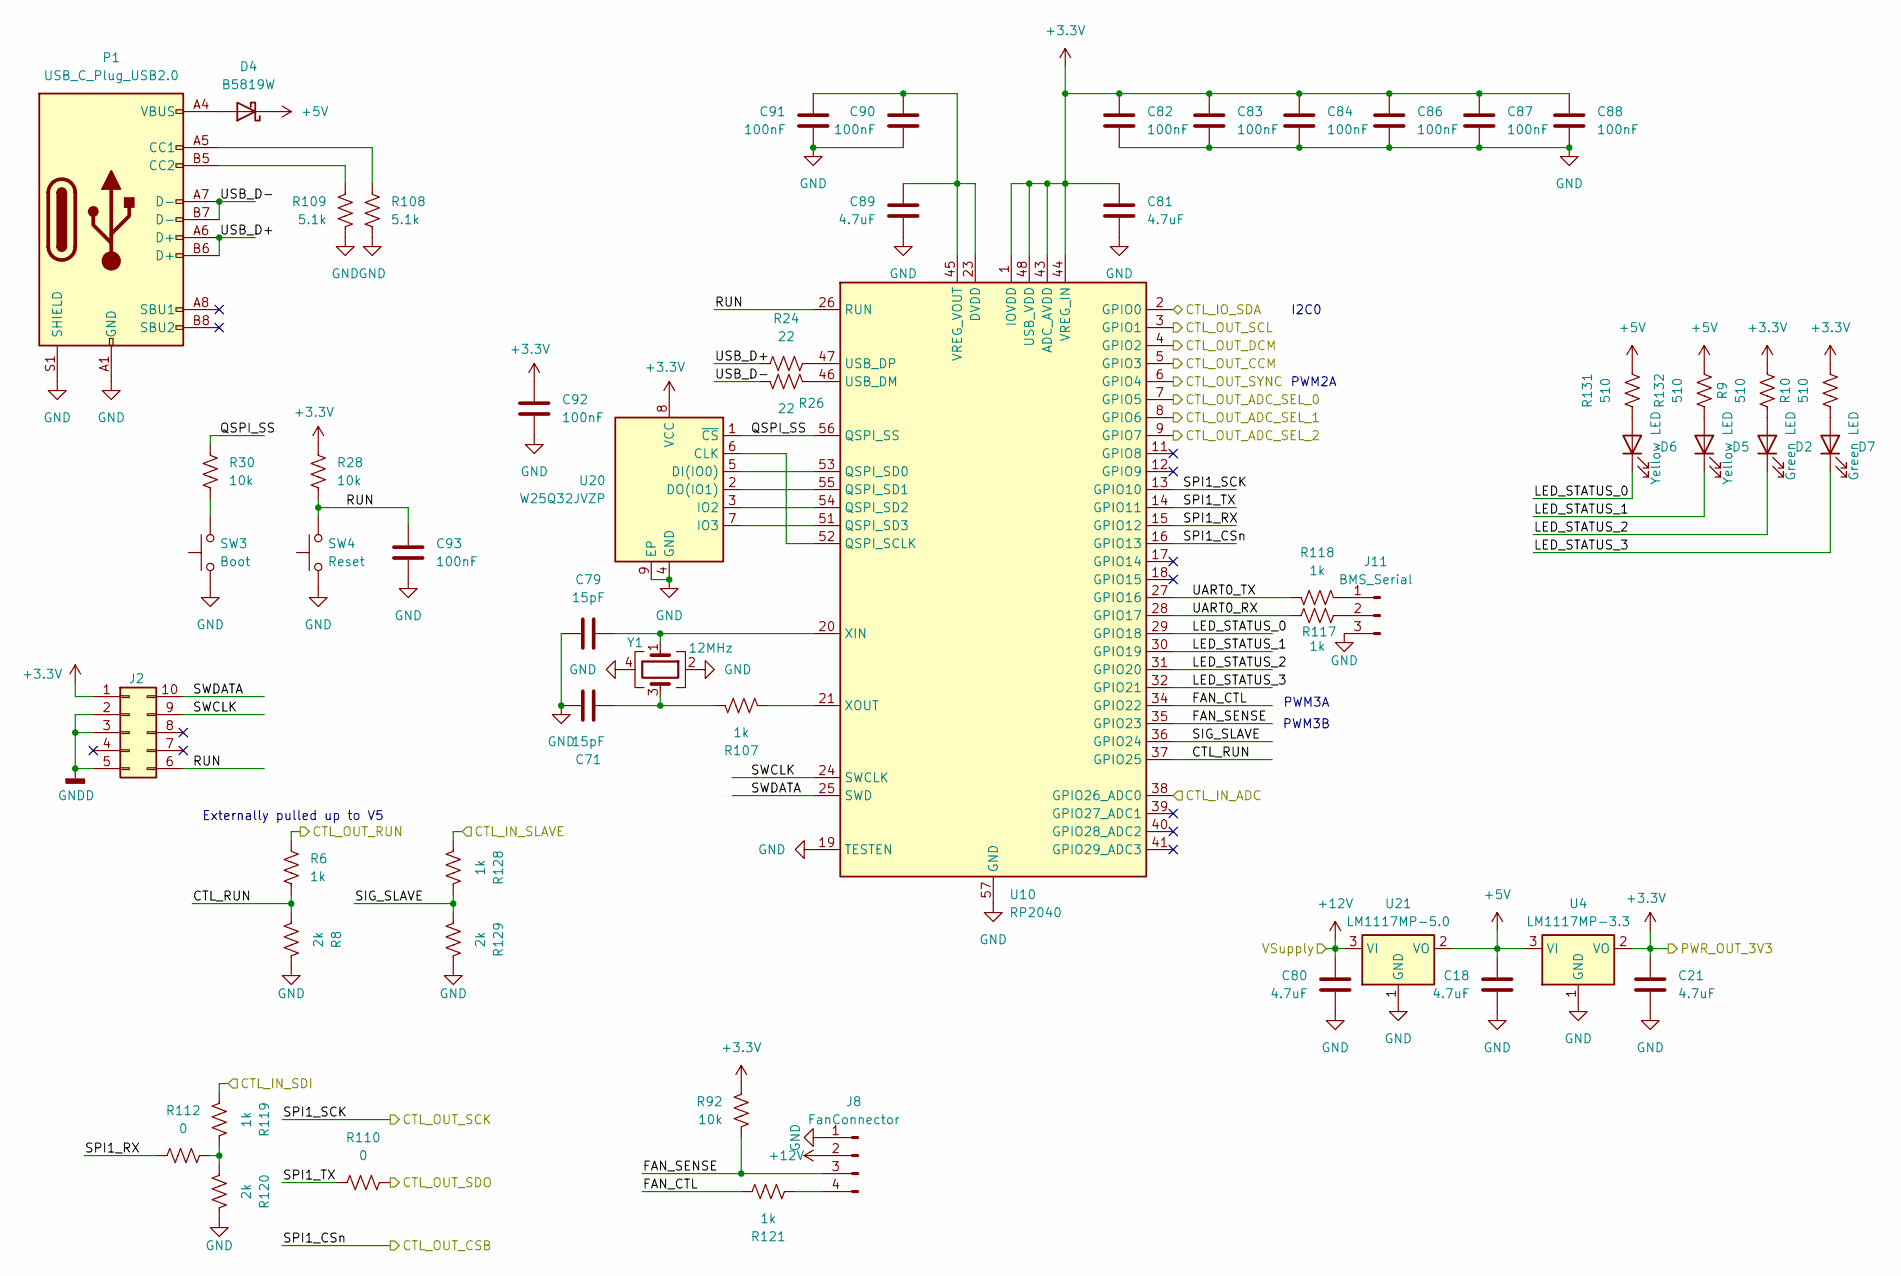
[picture p13: schematic control_stage.kicad_sch]

Parts:
C18, C21, C80, C81, C89: 4.7uF; C_0603_1608Metric; Digikey N/A
C71, C79: 15pF; C_0603_1608Metric; Digikey N/A
C82, C83, C84, C86, C87, C88, C90, C91, C92, C93: 100nF; C_0603_1608Metric; LCSC C14663
D2, D7: Green LED; LED_0805_2012Metric; LCSC C2297
D4: B5819W; D_SOD-123; LCSC C8598
D5, D6: Yellow LED; LED_0805_2012Metric; LCSC C2296
J2: JTAG_2x05_P1_27mm_Shrouded_SMD; Digikey 1175-1629-ND
J8: FanConnector; Molex_KK-254_AE-6410-04A_1x04_P2.54mm_Vertical; Digikey WM4330-ND
J11: BMS_Serial; Harwin_M20-89003xx_1x03_P2.54mm_Horizontal; Digikey 952-3232-ND
P1: USB_C_Plug_USB2.0; USB_C_Receptacle_GCT_USB4085; Digikey 2073-USB4085-GF-ACT-ND
R6, R107, R117, R118, R119, R121, R128: 1k; R_0603_1608Metric; Digikey N/A
R8, R120, R129: 2k; R_0603_1608Metric; Digikey N/A
R9, R10, R131, R132: 510; R_0603_1608Metric; Digikey N/A
R24, R26: 22; R_0603_1608Metric; LCSC C23345
R28, R30, R92: 10k; R_0603_1608Metric; LCSC C25804
R108, R109: 5.1k; R_0603_1608Metric; LCSC C23186
R110, R112: 0; R_0603_1608Metric; Digikey N/A
SW3: Boot; SW_SPST_EVQP2; Digikey P11081SCT-ND
SW4: Reset; SW_SPST_EVQP2; Digikey P11081SCT-ND
U4: LM1117MP-3.3; SOT-223-3_TabPin2; Digikey N/A
U10: RP2040; QFN-56-1EP_7x7mm_P0.4mm_EP3.2x3.2mm; Digikey 2648-SC0914(13)CT-ND
U20: W25Q32JVZP; WSON-8-1EP_6x5mm_P1.27mm_EP3.4x4.3mm; Digikey W25Q32JVZPIQ-ND
U21: LM1117MP-5.0; SOT-223-3_TabPin2; LCSC C6187
Y1: 12MHz; Crystal_SMD_3225-4Pin_3.2x2.5mm; Digikey XC2613CT-ND

Connections:
+3.3V: C21.1, C81.1, C82.1, C83.1, C84.1, C86.1, C87.1, C88.1, C92.1, J2.1, R9.1, R10.1, R28.2, R92.2, U4.2 (VO), U10.1 (IOVDD), U10.10 (IOVDD), U10.22 (IOVDD), U10.33 (IOVDD), U10.42 (IOVDD), U10.43 (ADC_AVDD), U10.44 (VREG_IN), U10.48 (USB_VDD), U10.49 (IOVDD), U20.8 (VCC); also elsewhere on the board
+5V: C18.1, D4.1 (K), R131.1, R132.1, U4.3 (VI), U21.2 (VO); also elsewhere on the board
+12V: C80.1, J8.2, U21.3 (VI); also elsewhere on the board
/ControlStage/CTL_IN_ADC: U10.38 (GPIO26_ADC0); also elsewhere on the board
/ControlStage/CTL_IN_SDI: R119.2; also elsewhere on the board
/ControlStage/CTL_IO_SDA: U10.2 (GPIO0); also elsewhere on the board
/ControlStage/CTL_OUT_ADC_SEL_0: U10.7 (GPIO5); also elsewhere on the board
/ControlStage/CTL_OUT_ADC_SEL_1: U10.8 (GPIO6); also elsewhere on the board
/ControlStage/CTL_OUT_ADC_SEL_2: U10.9 (GPIO7); also elsewhere on the board
/ControlStage/CTL_OUT_CCM: U10.5 (GPIO3); also elsewhere on the board
/ControlStage/CTL_OUT_DCM: U10.4 (GPIO2); also elsewhere on the board
/ControlStage/CTL_OUT_SCL: U10.3 (GPIO1); also elsewhere on the board
/ControlStage/CTL_OUT_SDO: R110.1; also elsewhere on the board
/ControlStage/CTL_OUT_SYNC: U10.6 (GPIO4); also elsewhere on the board
/ControlStage/CTL_RUN: R6.1, R8.2, U10.37 (GPIO25)
/ControlStage/FAN_CTL: R121.2, U10.34 (GPIO22)
/ControlStage/FAN_SENSE: J8.3, R92.1, U10.35 (GPIO23)
/ControlStage/LED_STATUS_0: D6.1 (K), U10.29 (GPIO18)
/ControlStage/LED_STATUS_1: D5.1 (K), U10.30 (GPIO19)
/ControlStage/LED_STATUS_2: D2.1 (K), U10.31 (GPIO20)
/ControlStage/LED_STATUS_3: D7.1 (K), U10.32 (GPIO21)
/ControlStage/QSPI_SS: R30.2, U10.56 (QSPI_SS), U20.1 (~CS)
/ControlStage/RUN: C93.1, J2.6, R28.1, SW4.2, U10.26 (RUN)
/ControlStage/SIG_SLAVE: R128.1, R129.2, U10.36 (GPIO24)
/ControlStage/SPI1_CSn: U10.16 (GPIO13); also elsewhere on the board
/ControlStage/SPI1_RX: R112.2, U10.15 (GPIO12)
/ControlStage/SPI1_SCK: U10.13 (GPIO10); also elsewhere on the board
/ControlStage/SPI1_TX: R110.2, U10.14 (GPIO11)
/ControlStage/SWCLK: J2.9, U10.24 (SWCLK)
/ControlStage/SWDATA: J2.10, U10.25 (SWD)
/ControlStage/UART0_RX: R117.2, U10.28 (GPIO17)
/ControlStage/UART0_TX: R118.2, U10.27 (GPIO16)
/ControlStage/USB_D+: P1.A6 (D+), P1.B6 (D+), R24.2
/ControlStage/USB_D-: P1.A7 (D-), P1.B7 (D-), R26.2
DC_INT_EN: R128.2; also elsewhere on the board
GND: C18.2, C21.2, C71.1, C79.1, C80.2, C81.2, C82.2, C83.2, C84.2, C86.2, C87.2, C88.2, C89.2, C90.2, C91.2, C92.2, C93.2, J2.2, J2.3, J2.5, J8.1, J11.3, P1.A1 (GND), P1.A12 (GND), P1.B1 (GND), P1.B12 (GND), P1.S1 (SHIELD), R8.1, R108.1, R109.1, R120.1, R129.1, SW3.1, SW4.1, U4.1 (GND), U10.19 (TESTEN), U10.57 (GND), U20.4 (GND), U20.9 (EP), U21.1 (GND), Y1.2, Y1.4; also elsewhere on the board
LTC_RUN: R6.2; also elsewhere on the board
unnamed: C71.2, R107.1, Y1.3
unnamed: D2.2 (A), R9.2
unnamed: D4.2 (A), P1.A4 (VBUS), P1.A9 (VBUS), P1.B4 (VBUS), P1.B9 (VBUS)
unnamed: D5.2 (A), R132.2
unnamed: D6.2 (A), R131.2
unnamed: D7.2 (A), R10.2
unnamed: J8.4, R121.1
unnamed: J11.1, R118.1
unnamed: J11.2, R117.1
unnamed: P1.A5 (CC1), R108.2
unnamed: P1.B5 (CC2), R109.2
unnamed: R30.1, SW3.2
unnamed: R112.1, R119.1, R120.2
unnamed: U10.52 (QSPI_SCLK), U20.6 (CLK)
unnamed: U10.53 (QSPI_SD0), U20.5 (DI(IO0))
unnamed: U10.55 (QSPI_SD1), U20.2 (DO(IO1))
unnamed: U10.54 (QSPI_SD2), U20.3 (IO2)
unnamed: U10.51 (QSPI_SD3), U20.7 (IO3)
unnamed: R26.1, U10.46 (USB_DM)
unnamed: R24.1, U10.47 (USB_DP)
unnamed: C89.1, C90.1, C91.1, U10.23 (DVDD), U10.45 (VREG_VOUT), U10.50 (DVDD)
unnamed: C79.2, U10.20 (XIN), Y1.1
unnamed: R107.2, U10.21 (XOUT)

Notes on the sheet:
PWM3A
PWM2A
I2C0
PWM3B
Externally pulled up to V5

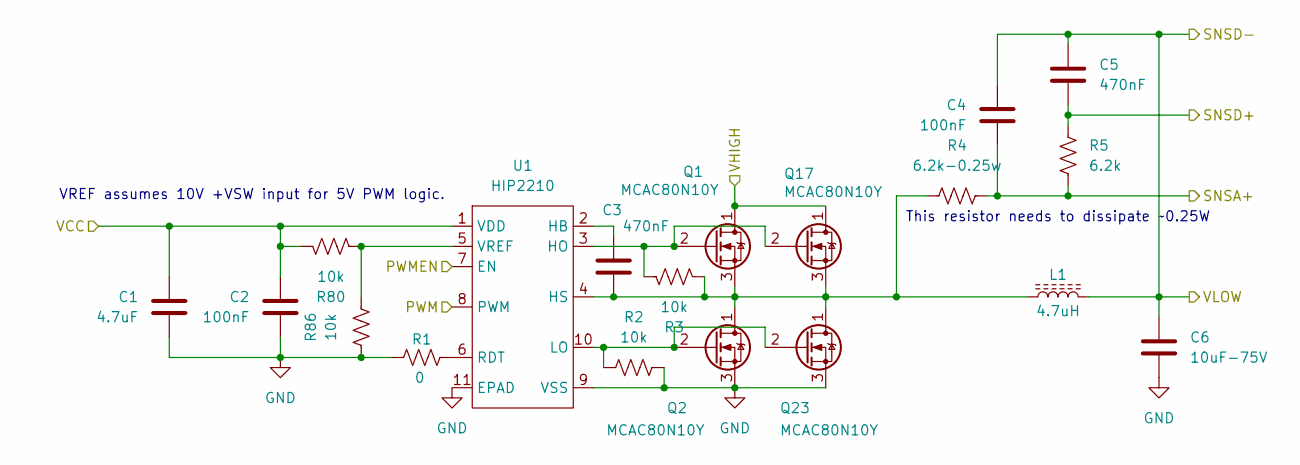
[picture p14: schematic power_stage_n.kicad_sch]

Parts:
C1: 4.7uF; C_0603_1608Metric; Digikey N/A
C2, C4: 100nF; C_0603_1608Metric; LCSC C14663
C3, C5: 470nF; C_0603_1608Metric; Digikey N/A
C6: 10uF-75V; C_1210_3225Metric_Pad1.33x2.70mm_HandSolder; Digikey 445-CGA6P1X7R1N106M250ACCT-ND
L1: 4.7uH; Bournes_L_PQ2614BLA; Digikey PQ2614BLA-3R3K-ND
Q1, Q2, Q17, Q23: MCAC80N10Y; TRANS_BSC076N06NS3-G; Digikey 353-MCAC80N10Y-TPCT-ND
R1: 0; R_0603_1608Metric; Digikey N/A
R2, R3, R80, R86: 10k; R_0603_1608Metric; LCSC C25804
R4: 6.2k-0.25w; R_1206_3216Metric_Pad1.30x1.75mm_HandSolder; Digikey 311-6.20KFRCT-ND
R5: 6.2k; R_0603_1608Metric; Digikey N/A
U1: HIP2210; TDFN-10-1EP_4x4mm_P0.8mm_EP2.6x3mm; Digikey 20-HIP2210FRTZ-TCT-ND

Connections:
+VSW: C1.1, C2.1, R80.2, U1.1 (VDD); also elsewhere on the board
/PowerStage/Phase1/PWM: U1.8 (PWM); also elsewhere on the board
/PowerStage/Phase1/SNSA+: C4.2, R4.2, R5.2; also elsewhere on the board
/PowerStage/Phase1/SNSD+: C5.2, R5.1; also elsewhere on the board
GND: C1.2, C2.2, C6.2, Q2.3 (S), Q23.3 (S), R1.1, R2.1, R86.2, U1.9 (VSS), U1.11 (EPAD); also elsewhere on the board
HT: Q1.1 (D), Q17.1 (D); also elsewhere on the board
LTC_PWMEN: U1.7 (EN); also elsewhere on the board
unnamed: Q1.2 (G), Q17.2 (G), R3.2, U1.3 (HO)
unnamed: C3.2, L1.1, Q1.3 (S), Q2.1 (D), Q17.3 (S), Q23.1 (D), R3.1, R4.1, U1.4 (HS)
unnamed: Q2.2 (G), Q23.2 (G), R2.2, U1.10 (LO)
unnamed: C3.1, U1.2 (HB)
unnamed: R1.2, U1.6 (RDT)
unnamed: R80.1, R86.1, U1.5 (VREF)
VLOW: C4.1, C5.1, C6.1, L1.2; also elsewhere on the board

Parts of its further copies:
C28, C34, C40, C46, C52: 4.7uF; C_0603_1608Metric; Digikey N/A
C29, C31, C35, C37, C41, C43, C47, C49, C53, C55: 100nF; C_0603_1608Metric; LCSC C14663
C30, C32, C36, C38, C42, C44, C48, C50, C54, C56: 470nF; C_0603_1608Metric; Digikey N/A
C33, C39, C45, C51, C57: 10uF-75V; C_1210_3225Metric_Pad1.33x2.70mm_HandSolder; Digikey 445-CGA6P1X7R1N106M250ACCT-ND
L2, L3, L4, L5, L6: 4.7uH; Bournes_L_PQ2614BLA; Digikey PQ2614BLA-3R3K-ND
Q7, Q8, Q9, Q10, Q11, Q12, Q13, Q14, Q15, Q16, Q18, Q19, Q20, Q21, Q22, Q24, Q25, Q26, Q27, Q28: MCAC80N10Y; TRANS_BSC076N06NS3-G; Digikey 353-MCAC80N10Y-TPCT-ND
R55, R60, R65, R70, R75: 0; R_0603_1608Metric; Digikey N/A
R56, R57, R61, R62, R66, R67, R71, R72, R76, R77, R81, R82, R83, R84, R85, R87, R88, R89, R90, R91: 10k; R_0603_1608Metric; LCSC C25804
R58, R63, R68, R73, R78: 6.2k-0.25w; R_1206_3216Metric_Pad1.30x1.75mm_HandSolder; Digikey 311-6.20KFRCT-ND
R59, R64, R69, R74, R79: 6.2k; R_0603_1608Metric; Digikey N/A
U5, U6, U7, U8, U9: HIP2210; TDFN-10-1EP_4x4mm_P0.8mm_EP2.6x3mm; Digikey 20-HIP2210FRTZ-TCT-ND

Connections of its further copies:
+VSW: C28.1, C29.1, C34.1, C35.1, C40.1, C41.1, C46.1, C47.1, C52.1, C53.1, R81.2, R82.2, R83.2, R84.2, R85.2, U5.1 (VDD), U6.1 (VDD), U7.1 (VDD), U8.1 (VDD), U9.1 (VDD); also elsewhere on the board
/PowerStage/Phase2/PWM: U5.8 (PWM); also elsewhere on the board
/PowerStage/Phase2/SNSA+: C31.2, R58.2, R59.2; also elsewhere on the board
/PowerStage/Phase2/SNSD+: C32.2, R59.1; also elsewhere on the board
/PowerStage/Phase3/PWM: U6.8 (PWM); also elsewhere on the board
/PowerStage/Phase3/SNSA+: C37.2, R63.2, R64.2; also elsewhere on the board
/PowerStage/Phase3/SNSD+: C38.2, R64.1; also elsewhere on the board
/PowerStage/Phase4/PWM: U7.8 (PWM); also elsewhere on the board
/PowerStage/Phase4/SNSA+: C43.2, R68.2, R69.2; also elsewhere on the board
/PowerStage/Phase4/SNSD+: C44.2, R69.1; also elsewhere on the board
/PowerStage/Phase5/PWM: U8.8 (PWM); also elsewhere on the board
/PowerStage/Phase5/SNSA+: C49.2, R73.2, R74.2; also elsewhere on the board
/PowerStage/Phase5/SNSD+: C50.2, R74.1; also elsewhere on the board
/PowerStage/Phase6/PWM: U9.8 (PWM); also elsewhere on the board
/PowerStage/Phase6/SNSA+: C55.2, R78.2, R79.2; also elsewhere on the board
/PowerStage/Phase6/SNSD+: C56.2, R79.1; also elsewhere on the board
GND: C28.2, C29.2, C33.2, C34.2, C35.2, C39.2, C40.2, C41.2, C45.2, C46.2, C47.2, C51.2, C52.2, C53.2, C57.2, Q8.3 (S), Q10.3 (S), Q12.3 (S), Q14.3 (S), Q16.3 (S), Q24.3 (S), Q25.3 (S), Q26.3 (S), Q27.3 (S), Q28.3 (S), R55.1, R56.1, R60.1, R61.1, R65.1, R66.1, R70.1, R71.1, R75.1, R76.1, R87.2, R88.2, R89.2, R90.2, R91.2, U5.9 (VSS), U5.11 (EPAD), U6.9 (VSS), U6.11 (EPAD), U7.9 (VSS), U7.11 (EPAD), U8.9 (VSS), U8.11 (EPAD), U9.9 (VSS), U9.11 (EPAD); also elsewhere on the board
HT: Q7.1 (D), Q9.1 (D), Q11.1 (D), Q13.1 (D), Q15.1 (D), Q18.1 (D), Q19.1 (D), Q20.1 (D), Q21.1 (D), Q22.1 (D); also elsewhere on the board
LTC_PWMEN: U5.7 (EN), U6.7 (EN), U7.7 (EN), U8.7 (EN), U9.7 (EN); also elsewhere on the board
unnamed: C36.2, L3.1, Q9.3 (S), Q10.1 (D), Q19.3 (S), Q25.1 (D), R62.1, R63.1, U6.4 (HS)
unnamed: Q10.2 (G), Q25.2 (G), R61.2, U6.10 (LO)
unnamed: Q11.2 (G), Q20.2 (G), R67.2, U7.3 (HO)
unnamed: C42.2, L4.1, Q11.3 (S), Q12.1 (D), Q20.3 (S), Q26.1 (D), R67.1, R68.1, U7.4 (HS)
unnamed: Q12.2 (G), Q26.2 (G), R66.2, U7.10 (LO)
unnamed: Q13.2 (G), Q21.2 (G), R72.2, U8.3 (HO)
unnamed: C48.2, L5.1, Q13.3 (S), Q14.1 (D), Q21.3 (S), Q27.1 (D), R72.1, R73.1, U8.4 (HS)
unnamed: Q14.2 (G), Q27.2 (G), R71.2, U8.10 (LO)
unnamed: Q15.2 (G), Q22.2 (G), R77.2, U9.3 (HO)
unnamed: C54.2, L6.1, Q15.3 (S), Q16.1 (D), Q22.3 (S), Q28.1 (D), R77.1, R78.1, U9.4 (HS)
unnamed: Q16.2 (G), Q28.2 (G), R76.2, U9.10 (LO)
unnamed: Q7.2 (G), Q18.2 (G), R57.2, U5.3 (HO)
unnamed: C30.2, L2.1, Q7.3 (S), Q8.1 (D), Q18.3 (S), Q24.1 (D), R57.1, R58.1, U5.4 (HS)
unnamed: Q9.2 (G), Q19.2 (G), R62.2, U6.3 (HO)
unnamed: Q8.2 (G), Q24.2 (G), R56.2, U5.10 (LO)
unnamed: C30.1, U5.2 (HB)
unnamed: R55.2, U5.6 (RDT)
unnamed: R81.1, R87.1, U5.5 (VREF)
unnamed: C36.1, U6.2 (HB)
unnamed: R60.2, U6.6 (RDT)
unnamed: R82.1, R88.1, U6.5 (VREF)
unnamed: C42.1, U7.2 (HB)
unnamed: R65.2, U7.6 (RDT)
unnamed: R83.1, R89.1, U7.5 (VREF)
unnamed: C48.1, U8.2 (HB)
unnamed: R70.2, U8.6 (RDT)
unnamed: R84.1, R90.1, U8.5 (VREF)
unnamed: C54.1, U9.2 (HB)
unnamed: R75.2, U9.6 (RDT)
unnamed: R85.1, R91.1, U9.5 (VREF)
VLOW: C31.1, C32.1, C33.1, C37.1, C38.1, C39.1, C43.1, C44.1, C45.1, C49.1, C50.1, C51.1, C55.1, C56.1, C57.1, L2.2, L3.2, L4.2, L5.2, L6.2; also elsewhere on the board

Notes on the sheet:
VREF assumes 10V +VSW input for 5V PWM logic.
This resistor needs to dissipate ~0.25W

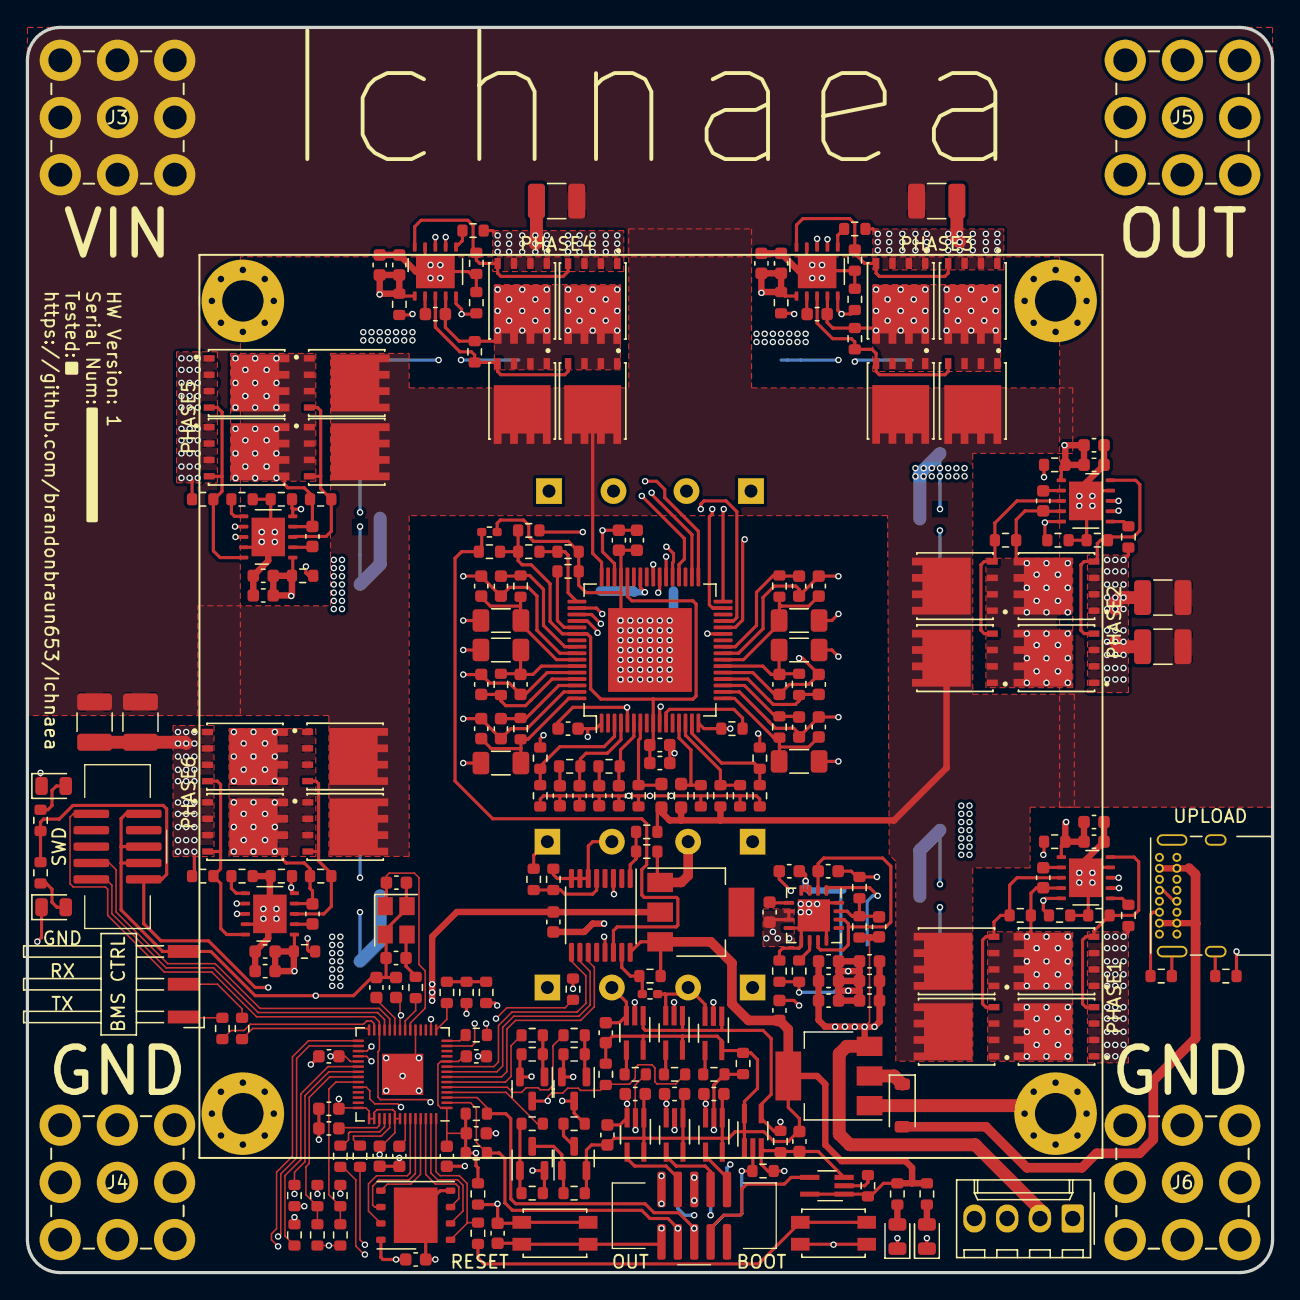
[picture p15: board IchnaeaV1.kicad_pcb from above]

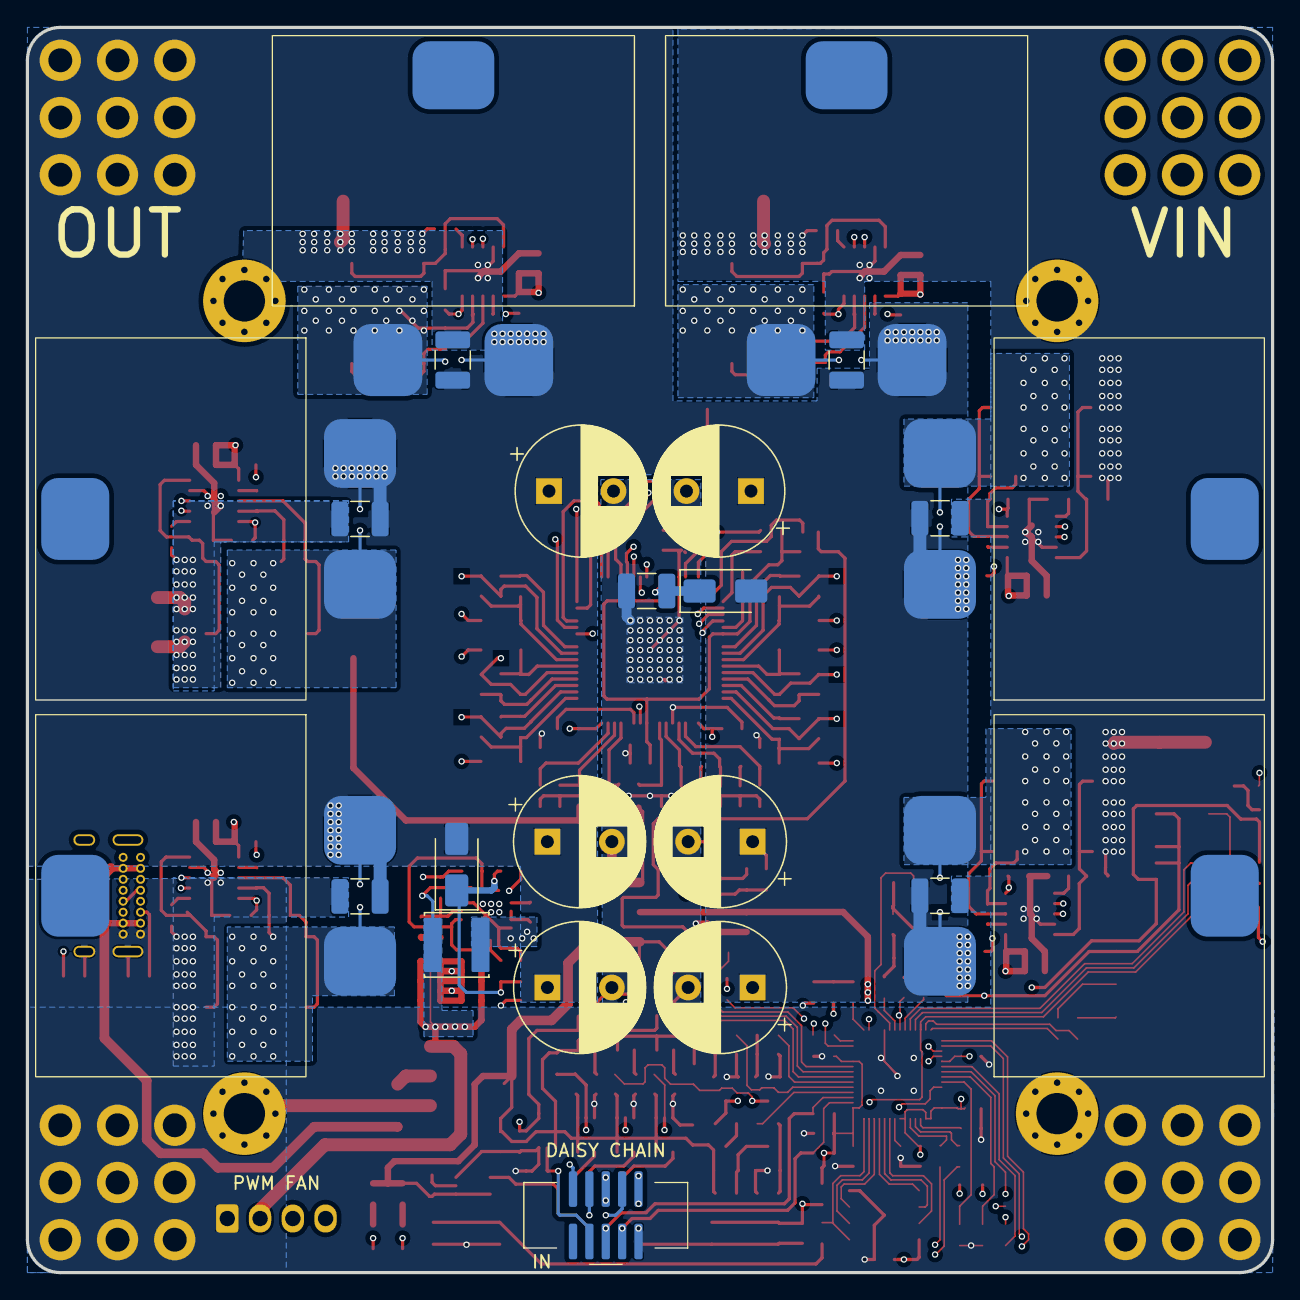
[picture p16: board IchnaeaV1.kicad_pcb from below]

Board: 4 copper layers, 96.5 x 96.5 mm, 283 parts (23 on the bottom side), 165 nets.
