brandonbraun653/Ichnaea/src/system/system_bootup.cpp

/******************************************************************************
 *  File Name:
 *    bootup.cpp
 *
 *  Description:
 *    Bootup routines for the hardware on startup
 *
 *  2024 | Brandon Braun | brandonbraun653@protonmail.com
 *****************************************************************************/

/*-----------------------------------------------------------------------------
Includes
-----------------------------------------------------------------------------*/
#include <mbedutils/assert.hpp>
#include <mbedutils/interfaces/exception_intf.hpp>
#include <mbedutils/logging.hpp>
#include <mbedutils/osal.hpp>
#include <src/bsp/board_map.hpp>
#include <src/com/ctrl_server.hpp>
#include <src/hw/adc.hpp>
#include <src/hw/fan.hpp>
#include <src/hw/gpio.hpp>
#include <src/hw/led.hpp>
#include <src/hw/ltc7871.hpp>
#include <src/hw/uart.hpp>
#include <src/system/system_bootup.hpp>
#include <src/system/system_db.hpp>
#include <src/system/system_error.hpp>
#include <src/system/system_logging.hpp>
#include <src/system/system_sensor.hpp>
#include <src/app/app_monitor.hpp>
#include <src/threads/ichnaea_threads.hpp>

namespace System::Boot
{
  /*---------------------------------------------------------------------------
  Public Functions
  ---------------------------------------------------------------------------*/

  void initDrivers()
  {
#if defined( ICHNAEA_EMBEDDED )
    timer_hw->dbgpause = 0;    // Do not pause the timer during debugging
#endif                         /* ICHNAEA_EMBEDDED */

    /*-------------------------------------------------------------------------
    Load system dependencies for the hardware (order matters here)
    -------------------------------------------------------------------------*/
    mb::osal::initOSALDrivers();
    mb::assert::initialize();
    Panic::powerUp();
    BSP::powerUp();

    /*-------------------------------------------------------------------------
    Initialize integration layers for the hardware
    -------------------------------------------------------------------------*/
    mb::hw::exception::intf::driver_setup();
    mb::hw::gpio::intf::driver_setup();
    mb::hw::spi::intf::driver_setup();

    /*-------------------------------------------------------------------------
    Initialize the hardware peripherals. Ordered by least complex/dependent
    to most complex/dependent.
    -------------------------------------------------------------------------*/
    HW::GPIO::initialize(); /* Must be first to init IO to a safe state */
    HW::LED::initialize();
    HW::ADC::initialize();
    HW::UART::initialize();
    HW::FAN::initialize();
    HW::LTC7871::driver_init();

    /*-------------------------------------------------------------------------
    Finally initialize the threading system. This should be the last thing to
    set up before the system is considered ready to execute.
    -------------------------------------------------------------------------*/
    Threads::initialize();
  }


  void initTech()
  {
    /*-------------------------------------------------------------------------
    Middle layer system drivers
    -------------------------------------------------------------------------*/
    Control::initialize();
    Logging::initialize();
    System::Database::initialize();
    System::Sensor::initialize();

    LOG_TRACE( "Tech stack initialization complete" );
  }


  void runPostInit()
  {
    Logging::postSequence();

    /*-------------------------------------------------------------------------
    Run the POST sequence for all hardware peripherals
    -------------------------------------------------------------------------*/
    LOG_TRACE( "Running POST sequence" );
    HW::LTC7871::postSequence();
    HW::LED::postSequence();
    HW::ADC::postSequence();
    HW::FAN::postSequence();
    LOG_TRACE( "POST sequence complete" );
  }

}    // namespace System::Boot
