brandonbraun653/Ichnaea/src/integration/mbedutils/mbedutils_prj_config.hpp

/******************************************************************************
 *  File Name:
 *    mbedutils_prj_config.hpp
 *
 *  Description:
 *    Project specific configuration file for the mb library.
 *
 *  2024 | Brandon Braun | brandonbraun653@protonmail.com
 *****************************************************************************/

#pragma once
#ifndef MBEDUTILS_PROJECT_CONFIG_HPP
#define MBEDUTILS_PROJECT_CONFIG_HPP

#define MBEDUTILS_LOGGING_MAX_SINKS ( 5 )

#endif /* !MBEDUTILS_PROJECT_CONFIG_HPP */
