brandonbraun653/Ichnaea/src/hw/sim_stubs.cpp

/******************************************************************************
 *  File Name:
 *    sim_stubs.cpp
 *
 *  Description:
 *    Stub implementations for the simulator.
 *
 *  2024 | Brandon Braun | brandonbraun653@protonmail.com
 *****************************************************************************/

/*-----------------------------------------------------------------------------
Includes
-----------------------------------------------------------------------------*/
#include <src/sim/sim_lifetime.hpp>

namespace SIM
{
  /*---------------------------------------------------------------------------
  Public Functions
  ---------------------------------------------------------------------------*/

  void initialize()
  {
    // Do nothing
  }


  void shutdown()
  {
    // Do nothing
  }
}    // namespace SIM
