brandonbraun653/Ichnaea/src/sim/hw/sim_gpio.cpp

/******************************************************************************
 *  File Name:
 *    gpio.cpp
 *
 *  Description:
 *    Ichnaea GPIO driver implementation
 *
 *  2024 | Brandon Braun | brandonbraun653@protonmail.com
 *****************************************************************************/

/*-----------------------------------------------------------------------------
Includes
-----------------------------------------------------------------------------*/
#include <src/hw/gpio.hpp>

namespace HW::GPIO
{
  /*---------------------------------------------------------------------------
  Public Functions
  ---------------------------------------------------------------------------*/

  void initialize()
  {
  }


  void set( const uint32_t pin, const bool state )
  {
  }


  bool get( const uint32_t pin )
  {
    return false;
  }
}  // namespace HW::GPIO
