brandonbraun653/Ichnaea/src/sim/hw/sim_led.cpp

/******************************************************************************
 *  File Name:
 *    led.cpp
 *
 *  Description:
 *    LED driver implementation
 *
 *  2024 | Brandon Braun | brandonbraun653@protonmail.com
 *****************************************************************************/

/*-----------------------------------------------------------------------------
Includes
-----------------------------------------------------------------------------*/
#include <src/hw/led.hpp>

namespace HW::LED
{
  /*---------------------------------------------------------------------------
  Public Functions
  ---------------------------------------------------------------------------*/

  void initialize()
  {
  }


  void postSequence()
  {
  }


  void enable( const unsigned int channel )
  {
  }


  void disable( const unsigned int channel )
  {
  }


  void toggle( const unsigned int channel )
  {
  }


  void setBrightness( const unsigned int channel, const float brightness )
  {
  }

}    // namespace HW::LED
