brandonbraun653/Ichnaea/(commit log)

2024-02-13 Start adding initial v1 design
    [IchnaeaV1.kicad_pcb, IchnaeaV1.kicad_sch, microcontrollers.kicad_sch, mppt_controller.kicad_sch, power_stage.kicad_sch, power_supply.kicad_sch, rf_controller.kicad_sch]
2024-02-14 Add personal kicad library
2024-02-15 Add virtual environment. Layout some schematic ideas. Add design doc for LTC7871.
    [IchnaeaV1.kicad_sch, microcontrollers.kicad_sch, mppt_controller.kicad_sch, power_stage.kicad_sch, power_supply.kicad_sch, rf_controller.kicad_sch]
2024-04-24 Pull up espressif lib to v3.0.0 for KiCAD 8 support
2024-05-30 Add hardware board version 1.0
    [IchnaeaV1.kicad_pcb, IchnaeaV1.kicad_sch, IchnaeaV1BOM.csv, bom.csv, control_stage.kicad_sch, designators.csv, low_voltage_supply.kicad_sch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]
2024-08-20 Add driver support for V1 of the board. Revision HW to v2.0.
    [GateDriverSupply.kicad_sch, IchnaeaV1.kicad_sch, IchnaeaV2.kicad_sch, Phase1Driver.kicad_sch, Phase2Driver.kicad_sch, Phase3Driver.kicad_sch, Phase4Driver.kicad_sch, Phase5Driver.kicad_sch]
2025-01-19 Add support for HW v2 of the board + system testing infrastructure
    [IchnaeaV2.kicad_sch, Phase1Driver.kicad_sch, Phase2Driver.kicad_sch, Phase3Driver.kicad_sch, Phase4Driver.kicad_sch, Phase5Driver.kicad_sch, Phase6Driver.kicad_sch, PowerStage.kicad_sch]
2025-01-23 Start working power stage control logic. Add dedicated thread for delayed IO operations.
2025-01-25 Validate power-on control flow
2025-01-26 Fix a configuration issue that led to bad Vout programming on the LTC7871
    [board_map.cpp, ltc7871_prv.cpp]
2025-01-26 Improve error reporting on system faults
    [ltc7871.cpp, ltc7871_prv.cpp, system_error.cpp, system_error.hpp]
2025-02-01 Start working on v3
    [GateDriverSupply.kicad_sch, IchnaeaV3.kicad_sch, PhaseNDriver.kicad_sch, PowerStage.kicad_sch, SophrosyneV1.kicad_pcb, SophrosyneV1.kicad_sch, analog_sensing.kicad_sch, batt_bms_balance_phase.kicad_sch]
2025-02-02 Experiment with a new power stage layout
    [IchnaeaV3.kicad_sch, PhaseNDriver.kicad_sch, PowerStage.kicad_sch, analog_sensing.kicad_sch, batt_bms_balance_phase.kicad_sch, battery_manager.kicad_sch, control_stage.kicad_sch, discrete_input.kicad_sch]
2025-02-06 Tested the V2 board at 1.15kW load. Made some notes on system design for V3.
    [IchnaeaV3.kicad_pcb]
2025-02-08 I might've made a critical error
    [IchnaeaV3.kicad_sch, PhaseNDriver.kicad_sch, PowerStage.kicad_sch, analog_sensing.kicad_sch, batt_bms_balance_phase.kicad_sch, battery_manager.kicad_sch, control_stage.kicad_sch, discrete_input.kicad_sch]
2025-02-08 Swiftly correct the design issue.
    [IchnaeaV3.kicad_sch, PowerStage.kicad_sch, analog_sensing.kicad_sch, control_stage.kicad_sch]
2025-02-09 Cost optimize power terminal connections
    [IchnaeaV3.kicad_pcb, IchnaeaV3.kicad_sch, PowerStage.kicad_sch, discrete_output.kicad_sch]
2025-02-15 Improve more of the power stage layout
    [IchnaeaV3.kicad_pcb, IchnaeaV3.kicad_sch, PhaseNDriver.kicad_sch, PowerStage.kicad_sch, analog_sensing.kicad_sch, batt_bms_balance_phase.kicad_sch, battery_manager.kicad_sch, charge_pump.kicad_sch]
2025-02-16 Start rework of power stage layout to shorten inductive path and increase current handling
    [IchnaeaV3.kicad_pcb, PhaseNDriver.kicad_sch, PowerStage.kicad_sch]
2025-02-18 Greatly improve power routing. Add gate control drive.
    [IchnaeaV3.kicad_pcb]
2025-02-22 Begin routing switching controller signals
    [IchnaeaV3.kicad_pcb, PowerStage.kicad_sch]
2025-02-23 Route power control signals. Upgrade to KiCad v9.0.0.
    [IchnaeaV3.kicad_pcb, IchnaeaV3.kicad_sch, PhaseNDriver.kicad_sch, PowerStage.kicad_sch, analog_sensing.kicad_sch, batt_bms_balance_phase.kicad_sch, battery_manager.kicad_sch, control_stage.kicad_sch]
2025-02-25 Sync lunch work
    [IchnaeaV3.kicad_pcb, PowerStage.kicad_sch]
2025-03-02 Split the design into four major components. Start working on system architecture.
    [BalancerV1.kicad_pcb, BalancerV1.kicad_sch, ChargerV3.kicad_pcb, ChargerV3.kicad_sch, ControllerV1.kicad_pcb, ControllerV1.kicad_sch, GateDriverSupply.kicad_sch, InterConnectV1.kicad_pcb]
2025-03-02 Redo some charger routing. Improve design for interconnect
    [ChargerV3.kicad_pcb, ControllerV1.kicad_sch, DevToolV1.kicad_pcb, DevToolV1.kicad_sch, InterConnectV1.kicad_pcb, InterConnectV1.kicad_sch, PowerStage.kicad_sch, analog_sensing.kicad_sch]
2025-03-03 Initial schematic for InterConnectV1
    [InterConnectV1.kicad_pcb, InterConnectV1.kicad_sch, PowerStage.kicad_sch]
2025-03-08 Nearly final charger schematic, updated with RS485 interconnect.
    [ChargerV3.kicad_pcb, ChargerV3.kicad_sch, InterConnectV1.kicad_sch, PowerStage.kicad_sch, analog_sensing.kicad_sch, control_stage.kicad_sch, mcu_control.kicad_sch]
2025-03-12 Sync board changes from before work started
    [ChargerV3.kicad_pcb, ChargerV3.kicad_sch, InterConnectV1.kicad_sch, PowerStage.kicad_sch, analog_sensing.kicad_sch, control_stage.kicad_sch, mcu_control.kicad_sch]
